MoseychukA/ASDB_INFO/README.md

# ASDB_INFO
Исходные файлы ADSB декодера
