MoseychukA/ASDB_INFO/adsbee-0.0.1/adsbee-0.0.1/excel/design_calculations.xlsx

Sheet: TLV3542 Noise Figure
Noise figure calculation paper: https://www.ti.com/lit/an/slyt094/slyt094.pdf
Parameter | Value | Units | Note

Sheet: AD8314 Input Match
Parameter | Value | Units | Note
Bandpass Filter
R_s | 52.3 | Ohms | Source impedance, from AD8314 datasheet (in parallel with AD8314 input, should yield 50 Ohms).
R_bp,L | 760 | Ohms | Resistance of AD8314 input at resonant frequency.
X_bp,L | -106 | j*Ohms | Reactance of AD8314 input at resonant frequency.
Z_bp_L | 767.3565012 | Ohms | Magnitude of bandpass filter load impedance (same as input impedance of AS8314 at bandpass filter resonant frequency).
f_r,bp,center | 1090 | MHz
w_r,bp,center | 6848.671985 | Mrad/s
Low Frequency
f_r,bp,lf | 1075 | MHz
w_r,bp,lf | 6754.424205 | Mrad/s
L_bp,lf | 6.8 | nH | Bandpass filter inductor value.
C_bp,lf | 3.223401637 | pF
C_bp,lf,bot | 20 | pF | Bottom capacitor value for tapped input of low frequency side of coupled resonator bandpass filter.
C_bp,lf_top | 3.842735657 | pF | Top capacitor value for tapped input of low frequency side of coupled resonator bandpass filter.
Coupling
R_bp,sp | 2013.41285 | Ohms | R_s' of coupled resonator equivalent circuit. Must be > Z_bp_L, preferably by a good amount.
X_bp,lf | -45.29801921 | j*Ohms | Reactance of bandpass filter low frequency resoinator's equivalent capacitor.
X_bp,lf,tot | -31.73597421 | j*Ohms
R_bp,lf,tot | 551.7367405 | Ohms
Q | 17.38521518 |  | Loaded Q of a single resonator in the bandpass filter. R is dominated by R_L. Q = X / R for reactance in prallel with resistance.
C_bp,coupling | 0.1854105114 | pF | Value of coupling capacitor connecting low frequency and high frequency resonators in bandpass filter.
L_bp,hf | 10 | nH
