MoseychukA/ASDB_INFO/adsbee-main/adsbee-main/firmware/ti/FreeRTOS-LTS/aws/aws-iot-core-mqtt-file-streams-embedded-c/docs/doxygen/images/MqttStreams_flowChart.jpg

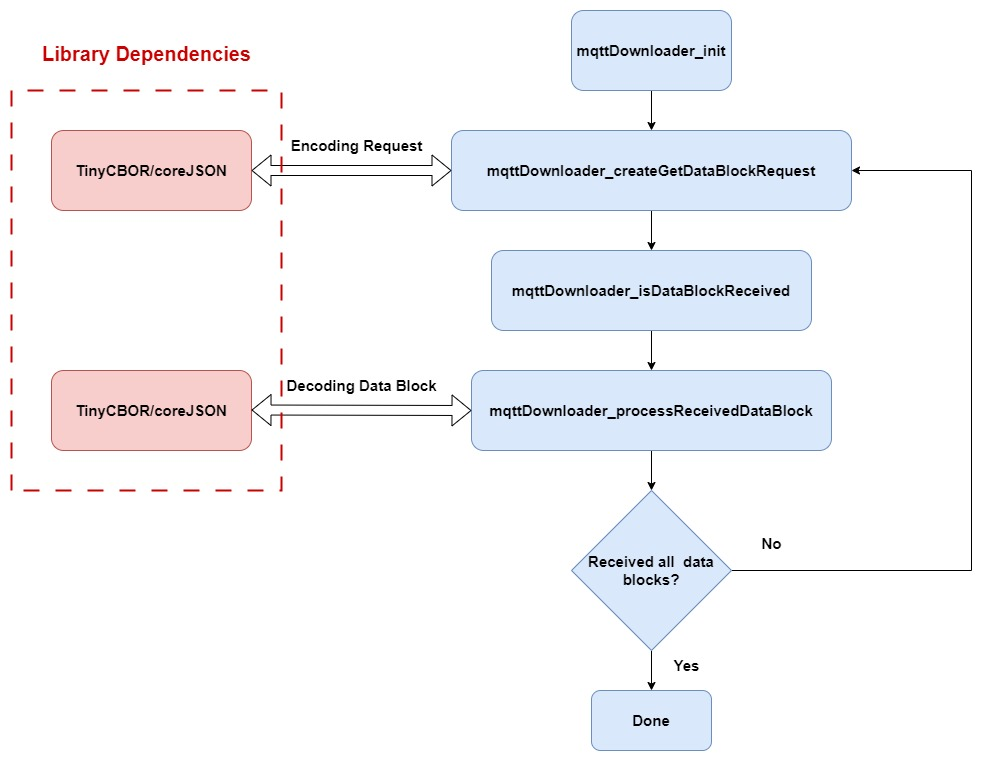
adsbee-main/adsbee-main/firmware/ti/FreeRTOS-LTS/aws/aws-iot-core-mqtt-file-streams-embedded-c/docs/doxygen/images/MqttStreams_flowChart.jpg
