MoseychukA/ASDB_INFO/adsbee-main/adsbee-main/firmware/ti/FreeRTOS-LTS/aws/sigv4-for-aws-iot-embedded-sdk/docs/plantuml/images/sigv4_design.png

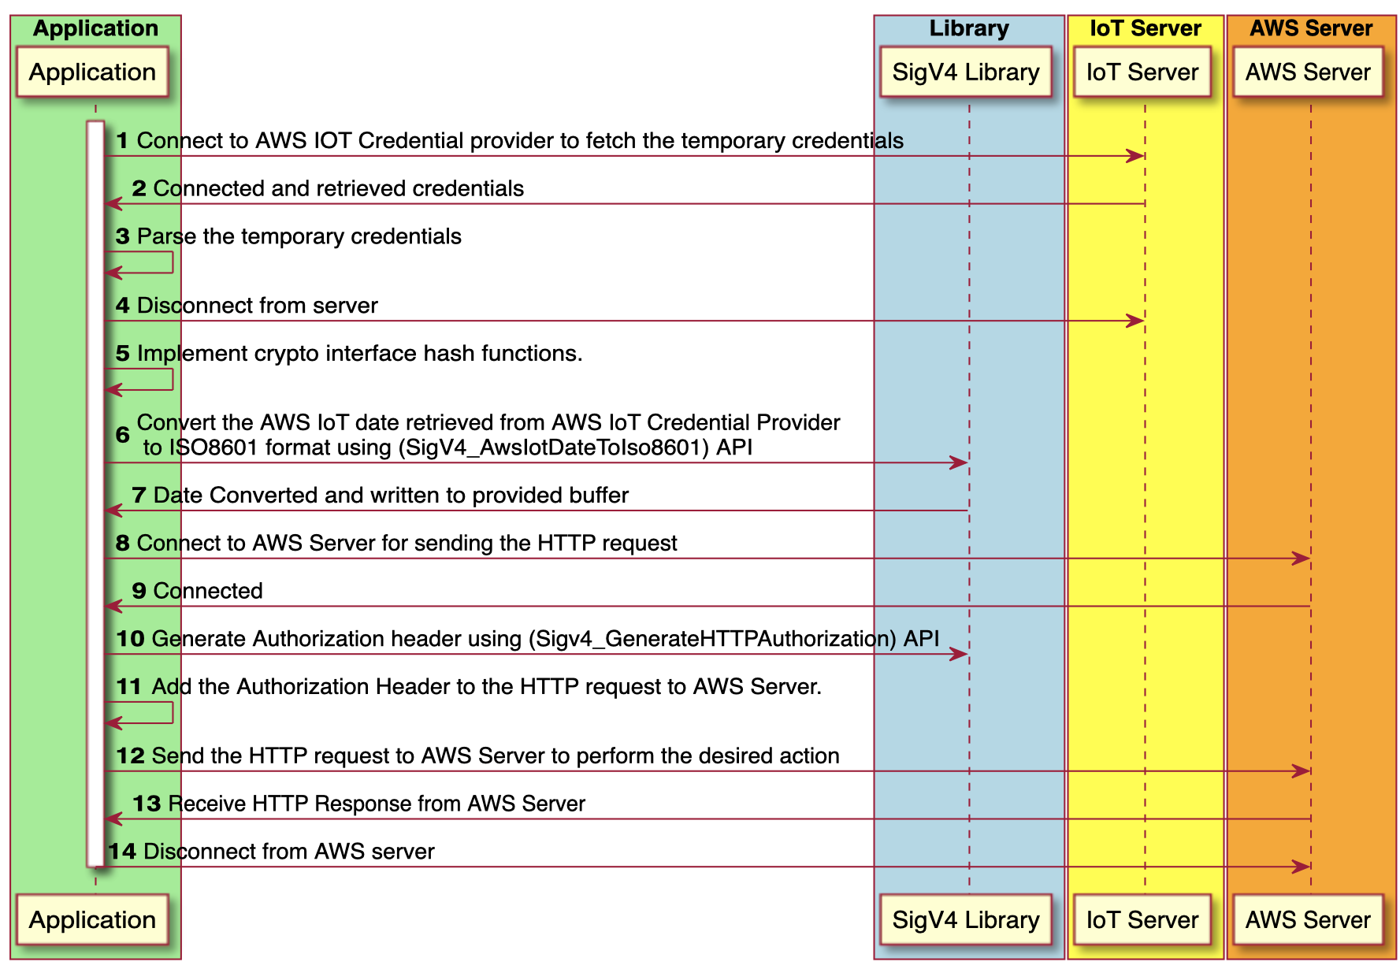
adsbee-main/adsbee-main/firmware/ti/FreeRTOS-LTS/aws/sigv4-for-aws-iot-embedded-sdk/docs/plantuml/images/sigv4_design.png
