MoseychukA/ASDB_INFO/DOC/2025-06-22_09-52-29.png

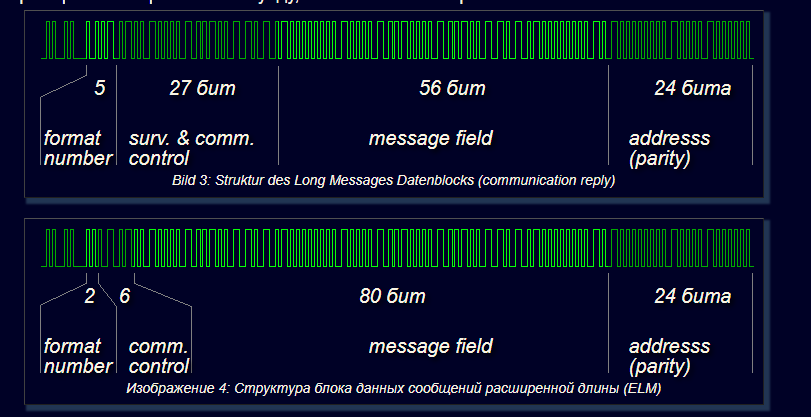
DOC/2025-06-22_09-52-29.png
