MoseychukA/ASDB_INFO/DOC/Pico1.webp

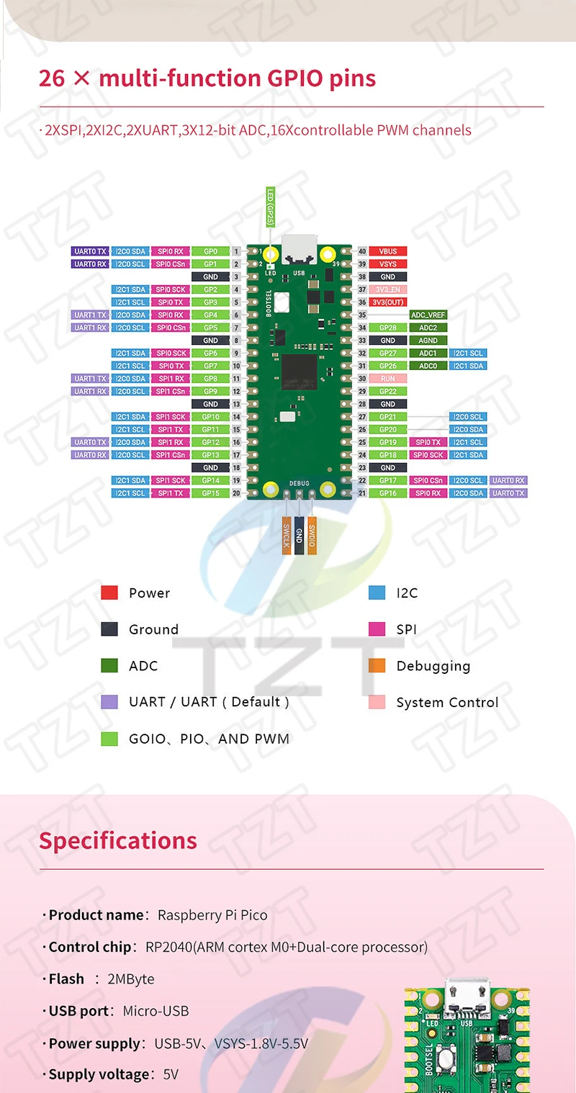
DOC/Pico1.webp
