MoseychukA/ASDB_INFO/DOC/Pico16.webp

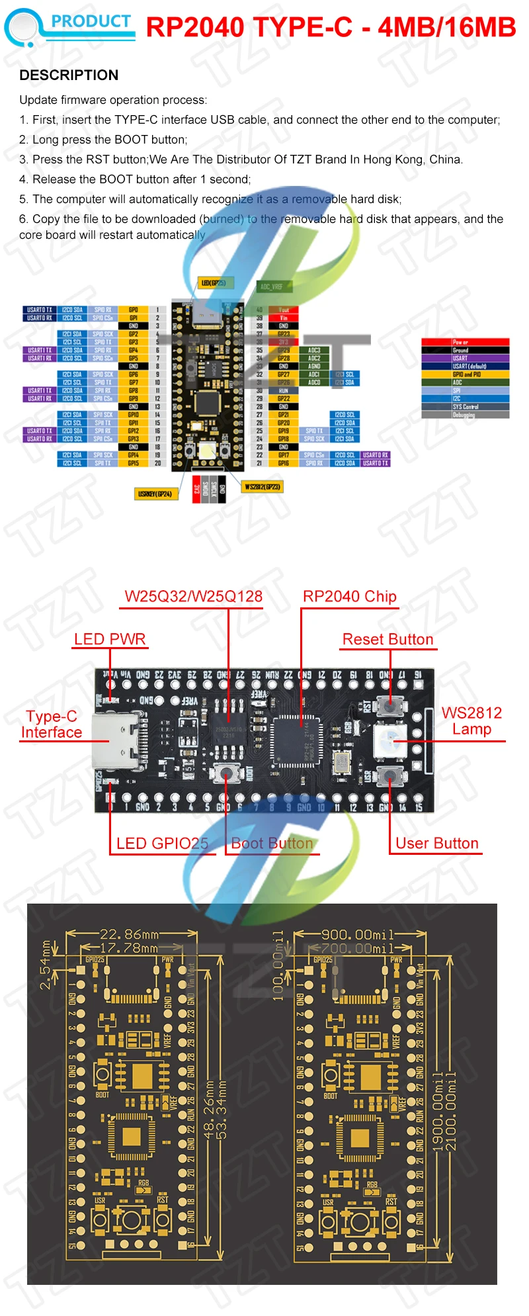
DOC/Pico16.webp
