MoseychukA/ASDB_INFO/Антенна 1090.png

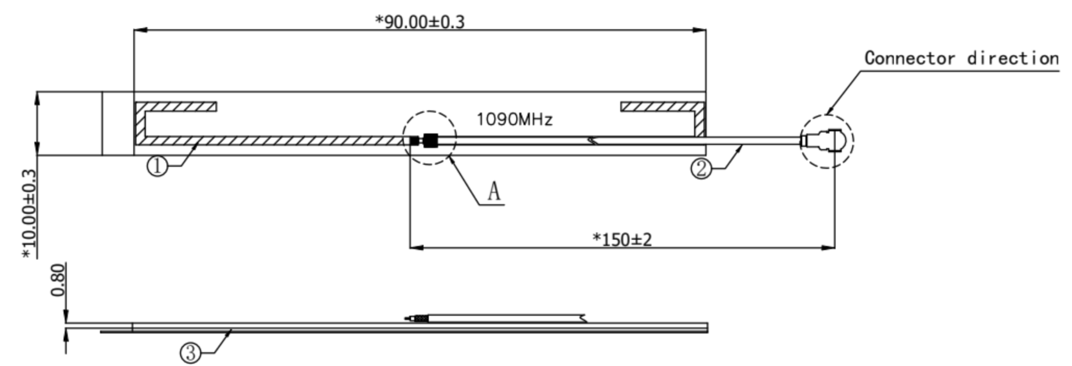
Антенна 1090.png
