MoseychukA/ASDB_INFO/adsbee-0.0.1/adsbee-0.0.1/affinity/promotional_materials/exports/adsbee_1090_qr.png

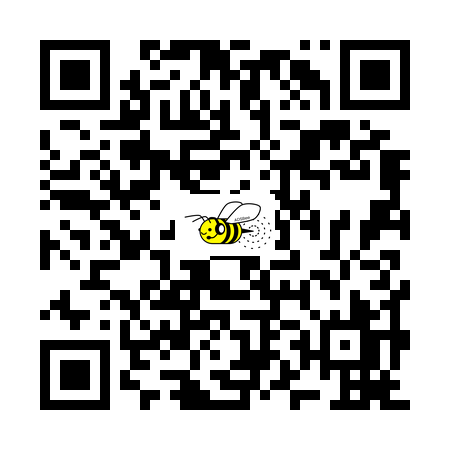
adsbee-0.0.1/adsbee-0.0.1/affinity/promotional_materials/exports/adsbee_1090_qr.png
