MoseychukA/ASDB_INFO/adsbee-adsbee_1090-0.8.0-rc3/adsbee-adsbee_1090-0.8.0-rc3/affinity/promotional_materials/exports/sticker_back_qr.png

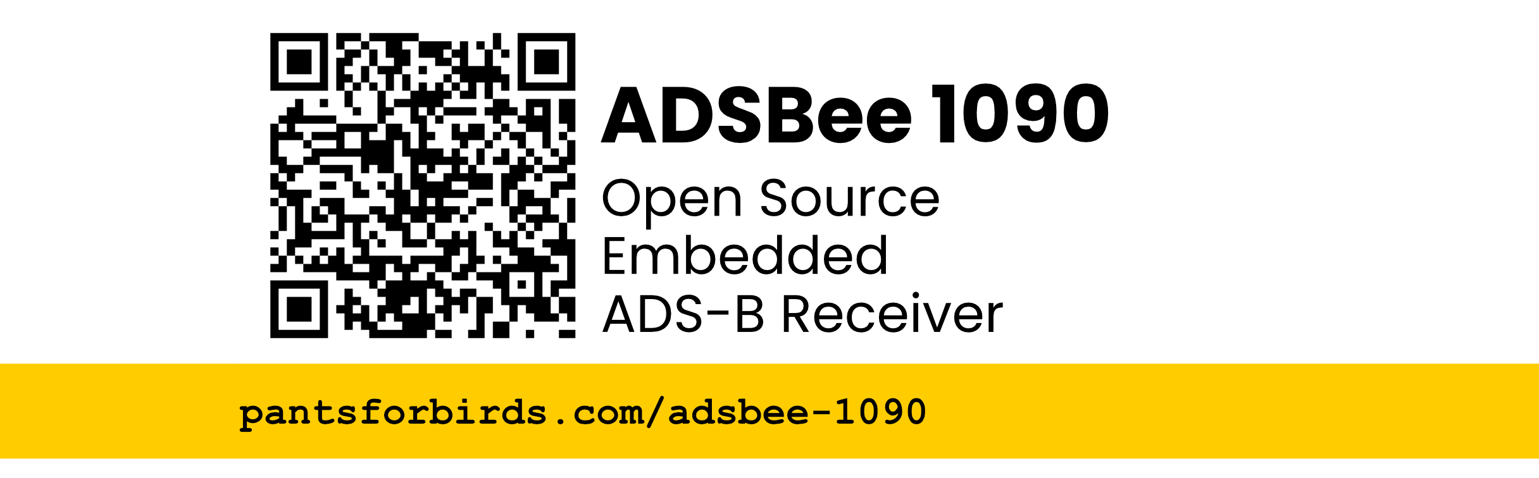
adsbee-adsbee_1090-0.8.0-rc3/adsbee-adsbee_1090-0.8.0-rc3/affinity/promotional_materials/exports/sticker_back_qr.png
