MoseychukA/ASDB_INFO/adsbee-0.0.1/adsbee-0.0.1/solidworks/proto_adsbee_1090_enclosure/fab/programming_plugs.STL

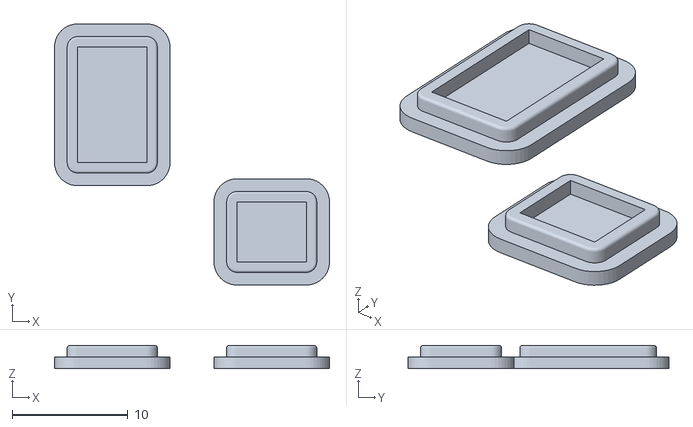
[picture p14: CAD file, 2025-06-20]
adsbee-0.0.1/adsbee-0.0.1/solidworks/proto_adsbee_1090_enclosure/fab/programming_plugs.STL
23.8 x 22.6 x 2.00
