MoseychukA/ASDB_INFO/adsbee-0.0.1/adsbee-0.0.1/solidworks/proto_adsbee_1090_solar_enclosure/adsbee_1090_solar_enclosure_backplane.SLDPRT

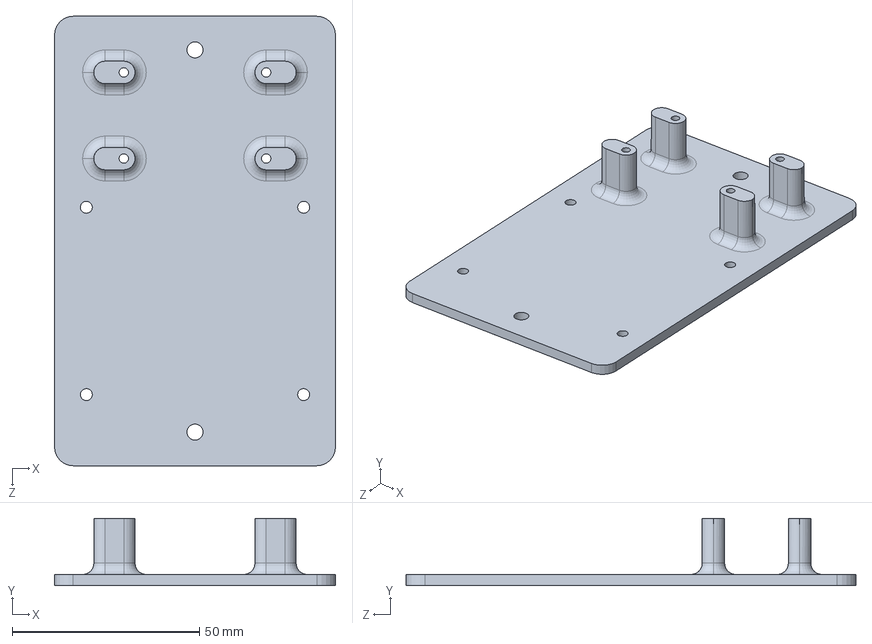
[picture p15: CAD file, 2025-06-20]
adsbee-0.0.1/adsbee-0.0.1/solidworks/proto_adsbee_1090_solar_enclosure/adsbee_1090_solar_enclosure_backplane.SLDPRT
75.0 x 18.0 x 120.0 mm
