MoseychukA/ASDB_INFO/adsbee-adsbee_1090-0.8.0-rc3/adsbee-adsbee_1090-0.8.0-rc3/3d/adsbee_1090_enclosure/Latch - B.stl

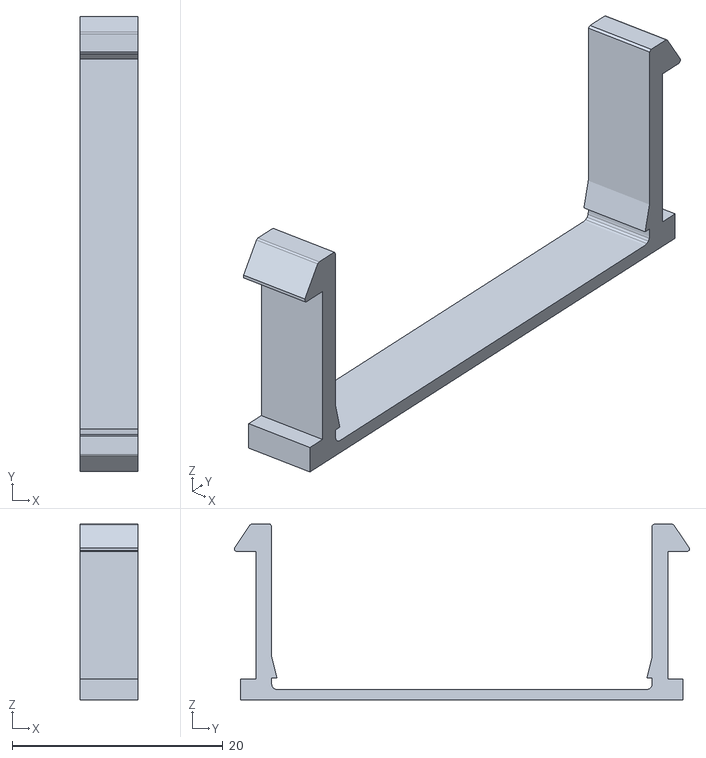
[picture p16: CAD file, 2025-06-20]
adsbee-adsbee_1090-0.8.0-rc3/adsbee-adsbee_1090-0.8.0-rc3/3d/adsbee_1090_enclosure/Latch - B.stl
5.50 x 43.2 x 16.7
