MoseychukA/ASDB_INFO/adsbee-adsbee_1090-0.8.0-rc3/adsbee-adsbee_1090-0.8.0-rc3/3d/adsbee_1090_indoor_feeder_enclosure/6x_indoor_feeder_enclosure_yellow_black.3mf

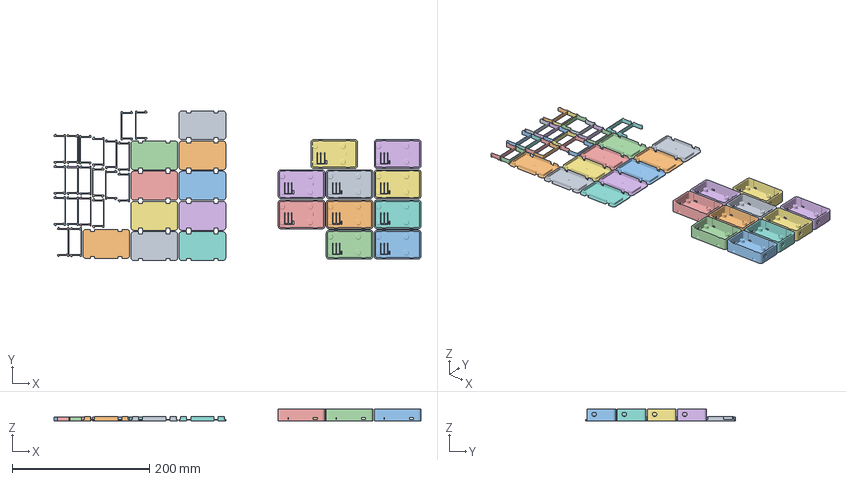
[picture p17: CAD file, 2025-06-20]
adsbee-adsbee_1090-0.8.0-rc3/adsbee-adsbee_1090-0.8.0-rc3/3d/adsbee_1090_indoor_feeder_enclosure/6x_indoor_feeder_enclosure_yellow_black.3mf
534.5 x 218.5 x 17.0 mm
Back Cover (Default) - B.stl x 10
Latch - B.stl x 20
Enclosure Front Cover - B.stl x 10
