MoseychukA/ASDB_INFO/adsbee-adsbee_1090-0.8.0-rc3/adsbee-adsbee_1090-0.8.0-rc3/3d/adsbee_1090_tall_enclosure/adsbee_1090_tall_enclosure_yellow_black.3mf

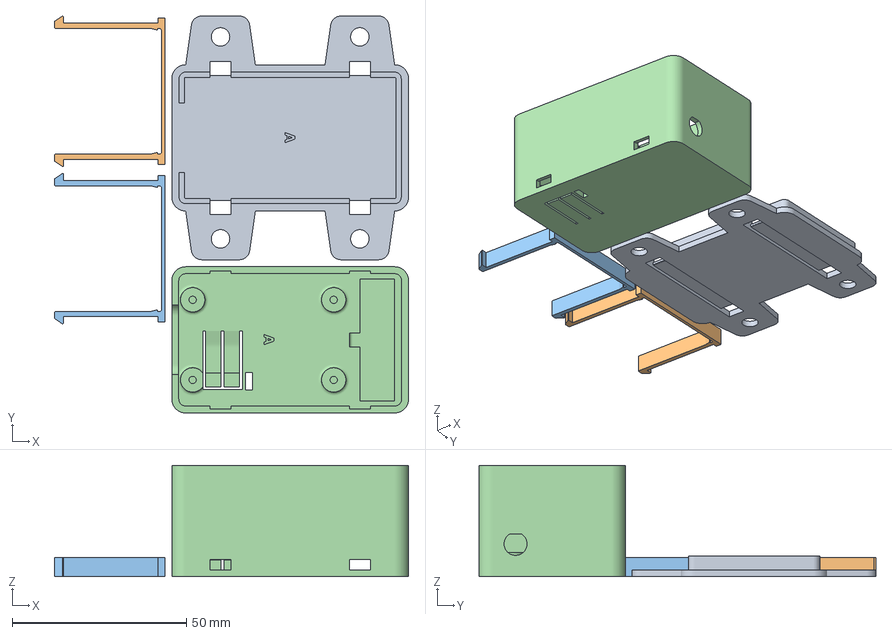
[picture p18: CAD file, 2025-06-20]
adsbee-adsbee_1090-0.8.0-rc3/adsbee-adsbee_1090-0.8.0-rc3/3d/adsbee_1090_tall_enclosure/adsbee_1090_tall_enclosure_yellow_black.3mf
101.7 x 114.0 x 32.0 mm
Back Cover.stl
Latch.stl x 2
Enclosure Front Cover.stl
