MoseychukA/ASDB_INFO/adsbee-adsbee_1090-0.8.0-rc3/adsbee-adsbee_1090-0.8.0-rc3/affinity/adsbee_logo/exports/adsbee_logo.dxf

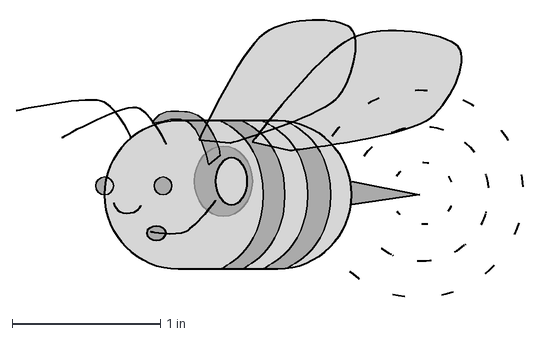
[picture p19: CAD file, 2025-06-20]
adsbee-adsbee_1090-0.8.0-rc3/adsbee-adsbee_1090-0.8.0-rc3/affinity/adsbee_logo/exports/adsbee_logo.dxf
3.42 x 1.90 in
