MoseychukA/ASDB_INFO/adsbee-main/adsbee-main/3d/adsbee_1090_tall_enclosure/Latch.stl

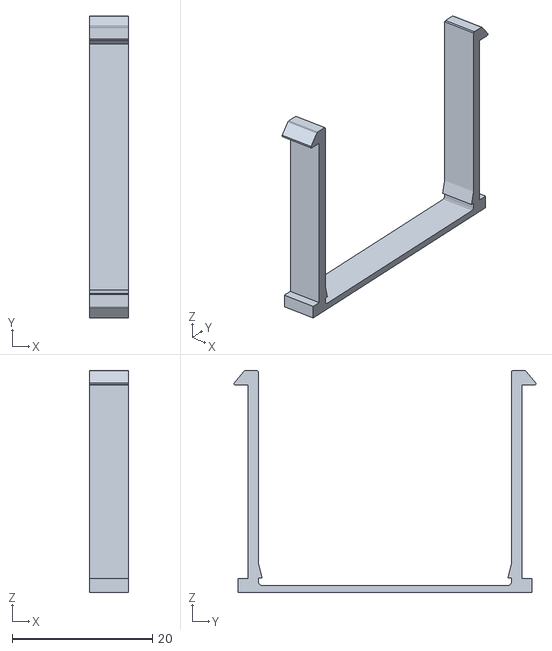
[picture p20: CAD file, 2025-06-20]
adsbee-main/adsbee-main/3d/adsbee_1090_tall_enclosure/Latch.stl
5.50 x 43.1 x 31.7
