MoseychukA/ASDB_INFO/adsbee-main/adsbee-main/affinity/adsbee_logo/exports/adsbee_logo_bw_outline.dxf

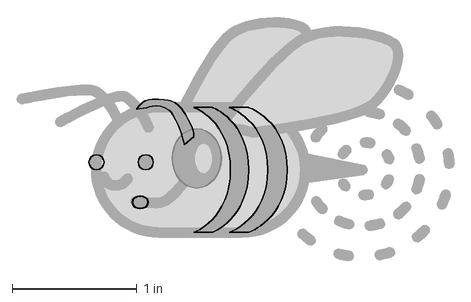
[picture p21: CAD file, 2025-06-20]
adsbee-main/adsbee-main/affinity/adsbee_logo/exports/adsbee_logo_bw_outline.dxf
3.51 x 1.96 in
