MoseychukA/ASDB_INFO/adsbee-0.0.1/adsbee-0.0.1/solidworks/proto_adsbee_1090_enclosure/fab/top_cover.STL

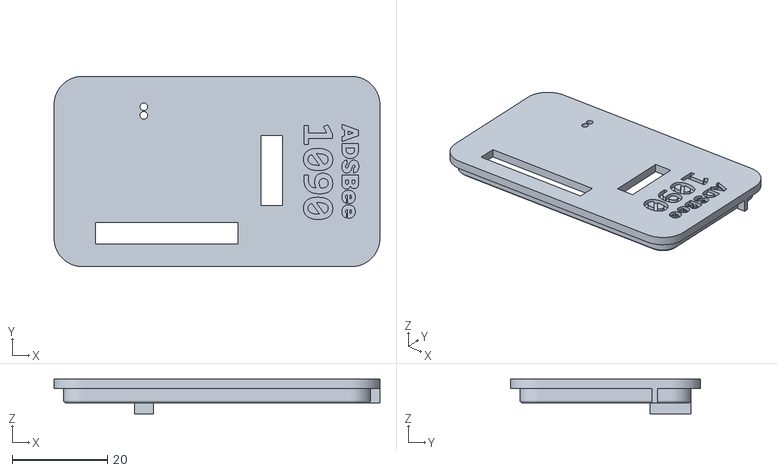
[picture p22: CAD file, 2025-06-20]
adsbee-0.0.1/adsbee-0.0.1/solidworks/proto_adsbee_1090_enclosure/fab/top_cover.STL
68.5 x 40.0 x 7.27
