MoseychukA/ASDB_INFO/adsbee-main/adsbee-main/3d/adsbee_1090_enclosure/indoor_feeder_enclosure_gray.3mf

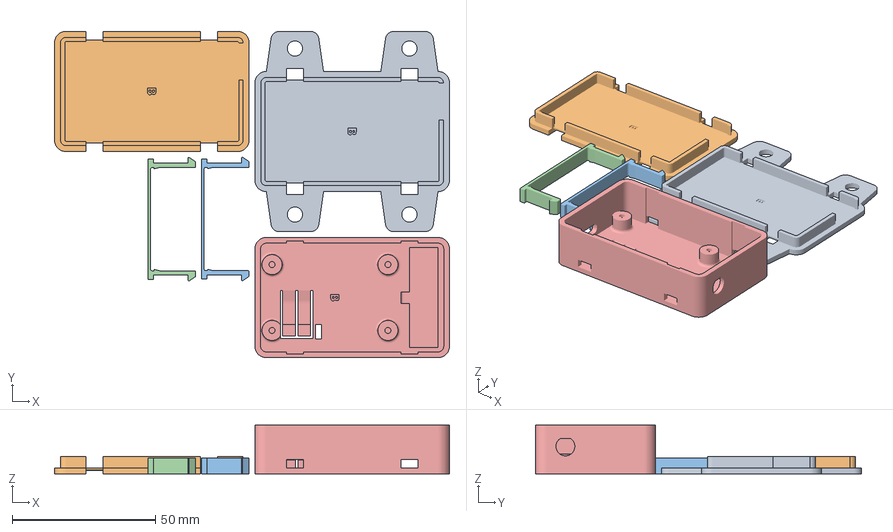
[picture p24: CAD file, 2025-06-20]
adsbee-main/adsbee-main/3d/adsbee_1090_enclosure/indoor_feeder_enclosure_gray.3mf
138.0 x 114.0 x 17.0 mm
Back Cover (Bracket) - B.stl
Back Cover (Default) - B.stl
Latch - B.stl x 2
Enclosure Front Cover - B.stl
