MoseychukA/ASDB_INFO/adsbee-0.0.1/adsbee-0.0.1/solidworks/proto_adsbee_1090_enclosure/fab/side_walls.STL

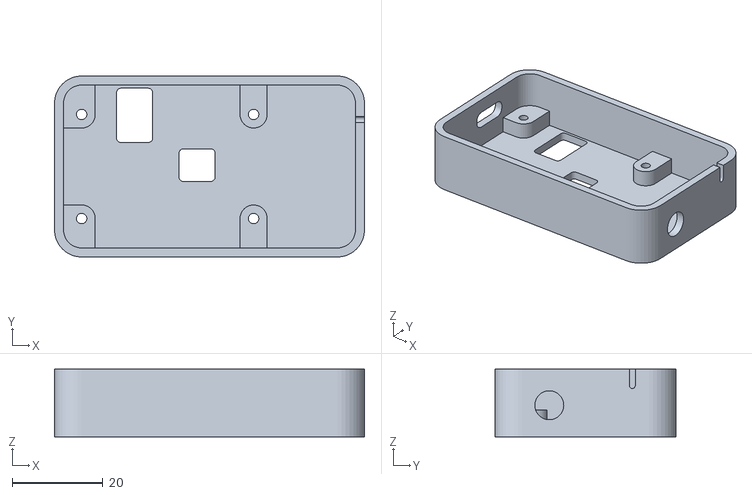
[picture p26: CAD file, 2025-06-20]
adsbee-0.0.1/adsbee-0.0.1/solidworks/proto_adsbee_1090_enclosure/fab/side_walls.STL
68.5 x 40.0 x 15.0
