MoseychukA/ASDB_INFO/adsbee-adsbee_1090-0.8.0-rc3/adsbee-adsbee_1090-0.8.0-rc3/3d/adsbee_1090_enclosure/Enclosure Front Cover - B.stl

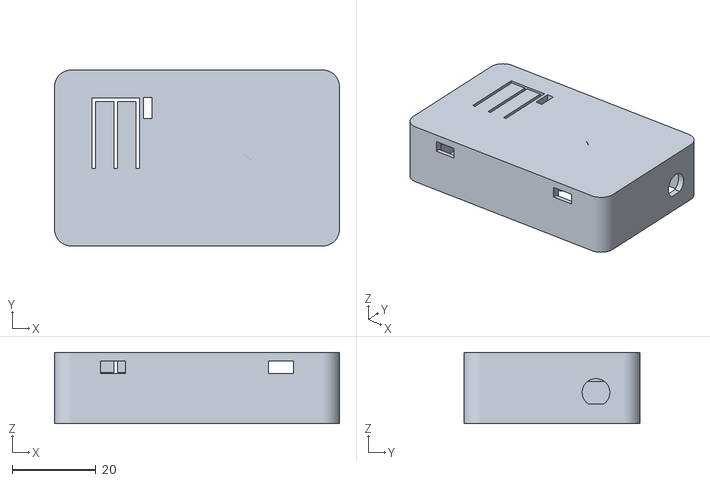
[picture p27: CAD file, 2025-06-20]
adsbee-adsbee_1090-0.8.0-rc3/adsbee-adsbee_1090-0.8.0-rc3/3d/adsbee_1090_enclosure/Enclosure Front Cover - B.stl
68.0 x 42.0 x 17.0
