MoseychukA/ASDB_INFO/adsbee-main/adsbee-main/3d/adsbee_1090_enclosure/Back Cover (Bracket) - B.stl

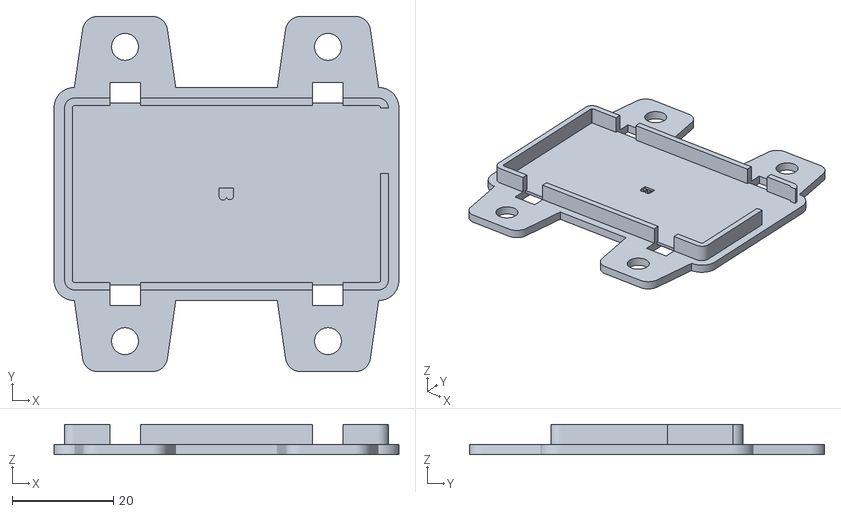
[picture p28: CAD file, 2025-06-20]
adsbee-main/adsbee-main/3d/adsbee_1090_enclosure/Back Cover (Bracket) - B.stl
68.0 x 70.0 x 6.00
