MoseychukA/ASDB_INFO/adsbee-main/adsbee-main/3d/adsbee_1090_tall_enclosure/Enclosure Front Cover.stl

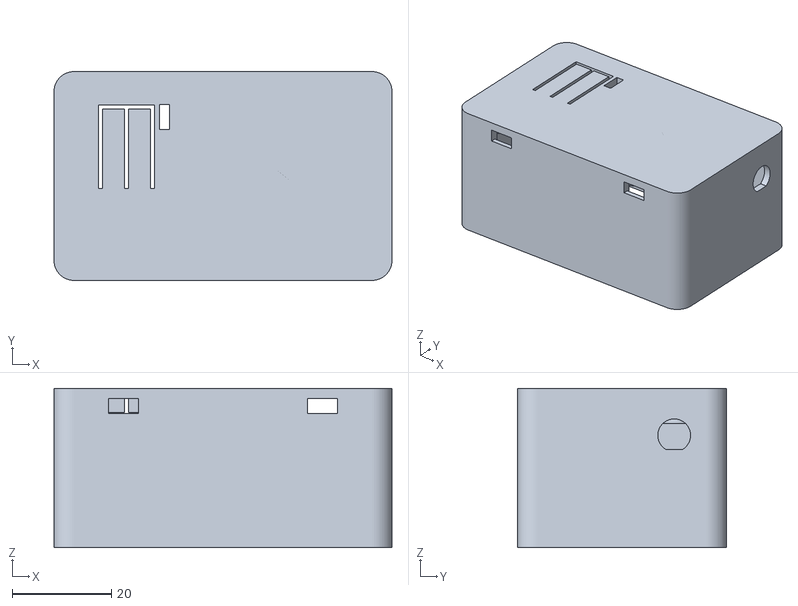
[picture p29: CAD file, 2025-06-20]
adsbee-main/adsbee-main/3d/adsbee_1090_tall_enclosure/Enclosure Front Cover.stl
68.0 x 42.0 x 32.0
