MoseychukA/ASDB_INFO/adsbee-main/adsbee-main/3d/adsbee_1090_enclosure/6x_indoor_feeder_enclosure_gray.3mf

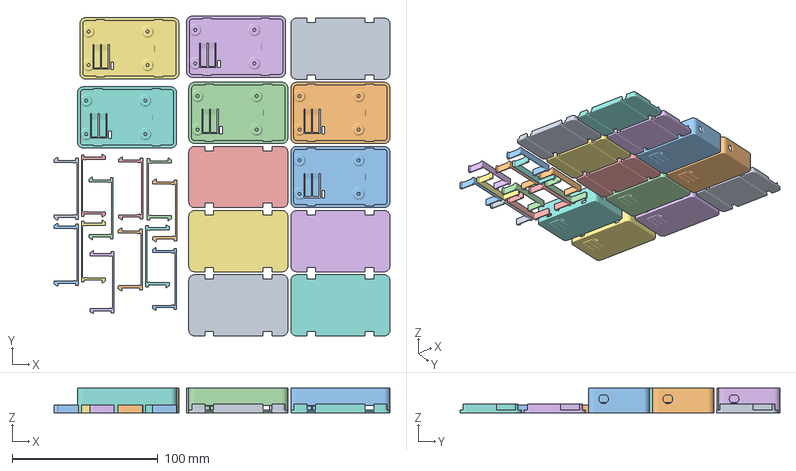
[picture p30: CAD file, 2025-06-20]
adsbee-main/adsbee-main/3d/adsbee_1090_enclosure/6x_indoor_feeder_enclosure_gray.3mf
230.4 x 219.4 x 17.0 mm
Back Cover (Default) - B.stl x 6
Enclosure Front Cover - B.stl x 6
Latch - B.stl x 12
