MoseychukA/ASDB_INFO/(list of files, cad)

Other CAD files:
adsbee-0.0.1/adsbee-0.0.1/solidworks/proto_adsbee_1090_solar_enclosure/fab/adsbee_1090_solar_enclosure_backplane.STL
adsbee-main/adsbee-main/3d/adsbee_1090_enclosure/indoor_feeder_enclosure.3mf.3mf
adsbee-adsbee_1090-0.8.0-rc3/adsbee-adsbee_1090-0.8.0-rc3/3d/adsbee_1090_enclosure/indoor_feeder_enclosure.3mf.3mf
adsbee-main/adsbee-main/3d/adsbee_1090_enclosure/10x_indoor_feeder_enclosure_yellow_black.3mf
adsbee-adsbee_1090-0.8.0-rc3/adsbee-adsbee_1090-0.8.0-rc3/3d/adsbee_1090_enclosure/10x_indoor_feeder_enclosure_yellow_black.3mf
