MoseychukA/ASDB_INFO/adsbee-adsbee_1090-0.8.0-rc3/adsbee-adsbee_1090-0.8.0-rc3/affinity/adsbee_1090_wiring_diagrams/exports/adsbee_1090_w5500_lite.png

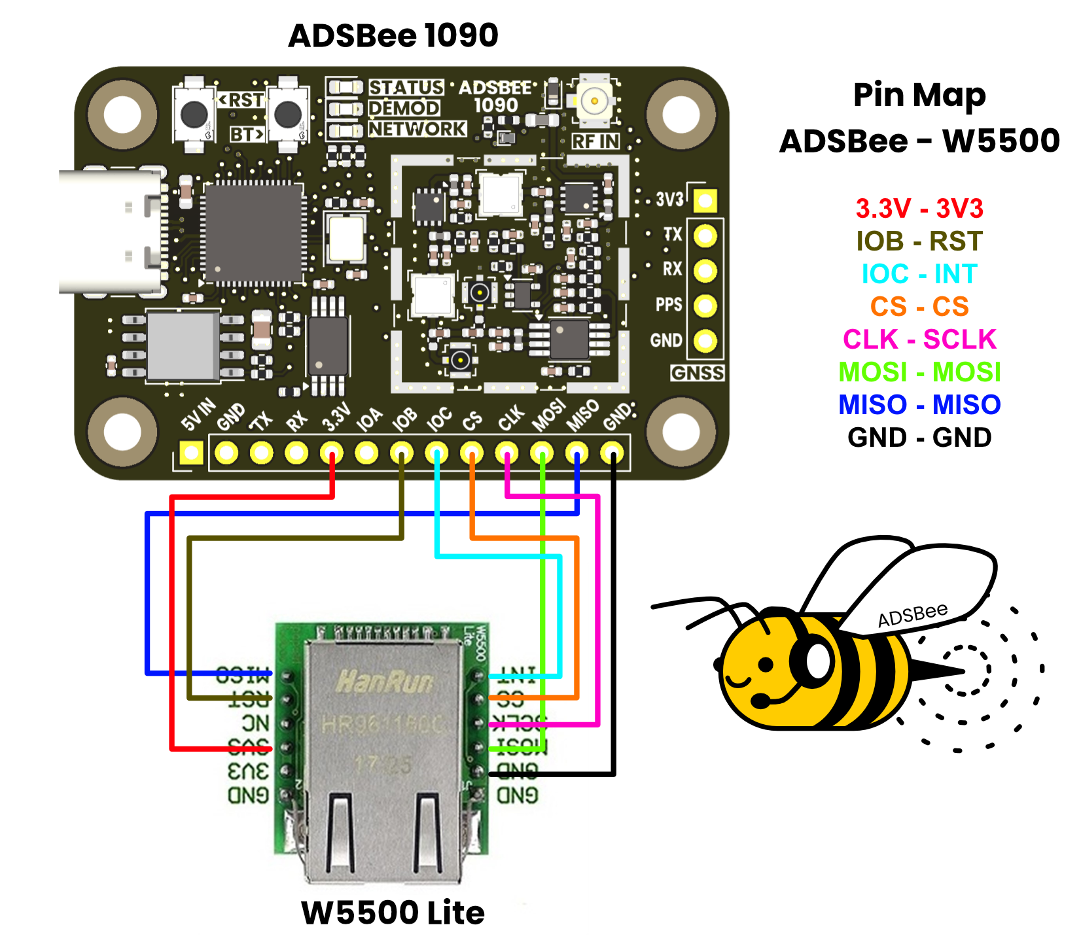
adsbee-adsbee_1090-0.8.0-rc3/adsbee-adsbee_1090-0.8.0-rc3/affinity/adsbee_1090_wiring_diagrams/exports/adsbee_1090_w5500_lite.png
