MoseychukA/ASDB_INFO/adsbee-main/adsbee-main/firmware/ti/FreeRTOS-LTS/aws/device-defender-for-aws-iot-embedded-sdk/docs/plantuml/images/defender_design_operations.png

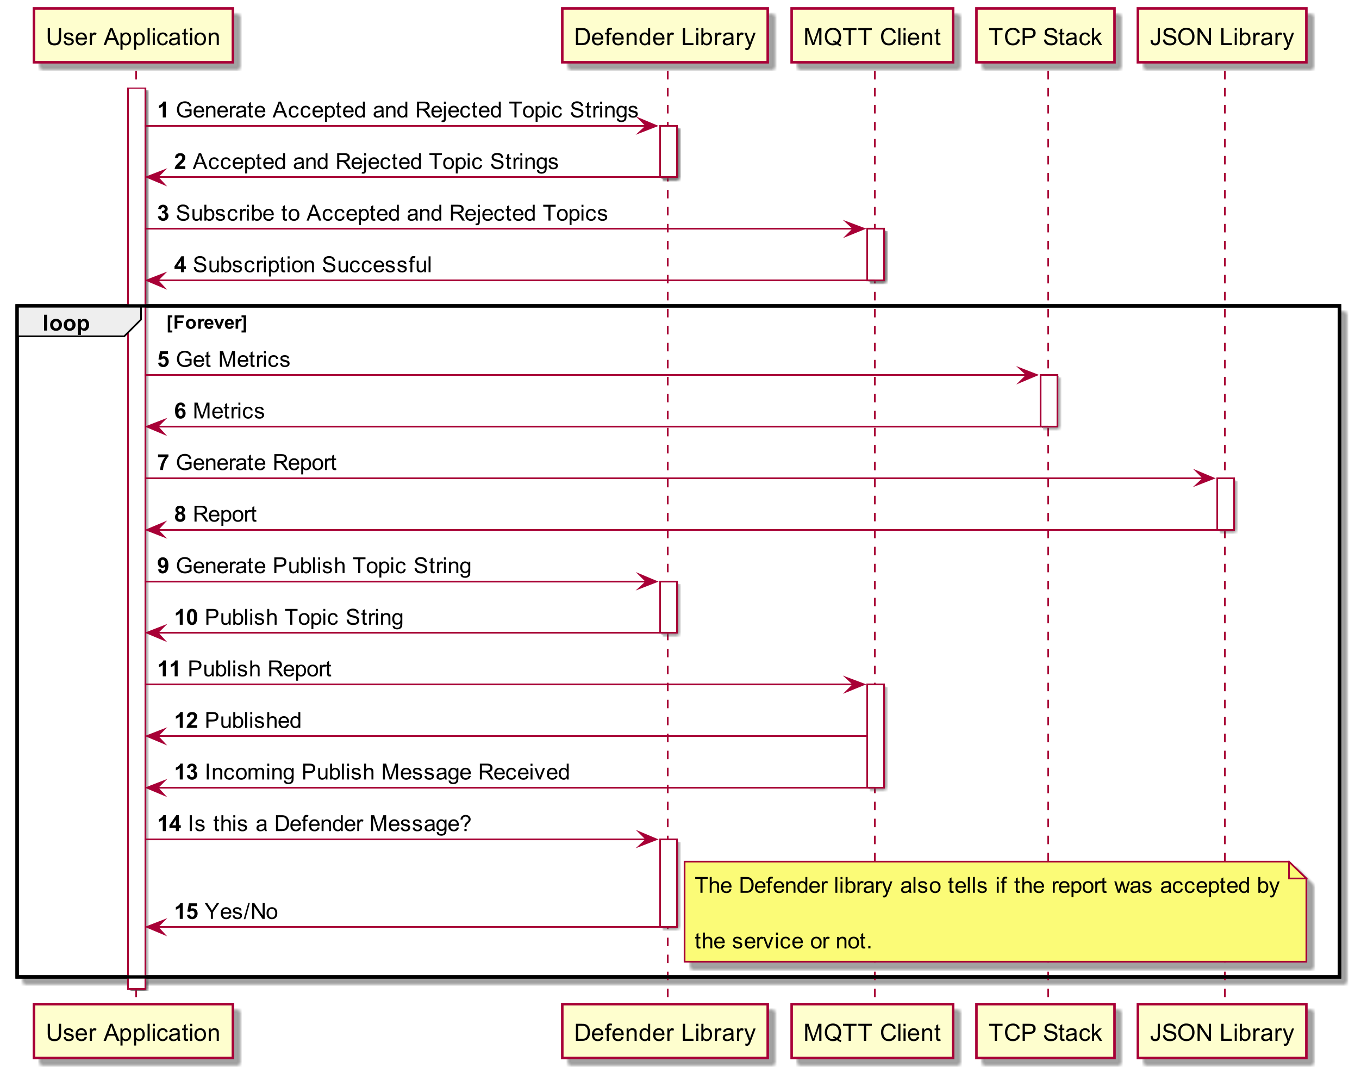
adsbee-main/adsbee-main/firmware/ti/FreeRTOS-LTS/aws/device-defender-for-aws-iot-embedded-sdk/docs/plantuml/images/defender_design_operations.png
