MoseychukA/ASDB_INFO/adsbee-main/adsbee-main/firmware/ti/FreeRTOS-LTS/aws/device-shadow-for-aws-iot-embedded-sdk/docs/plantuml/images/shadow_design_operation.png

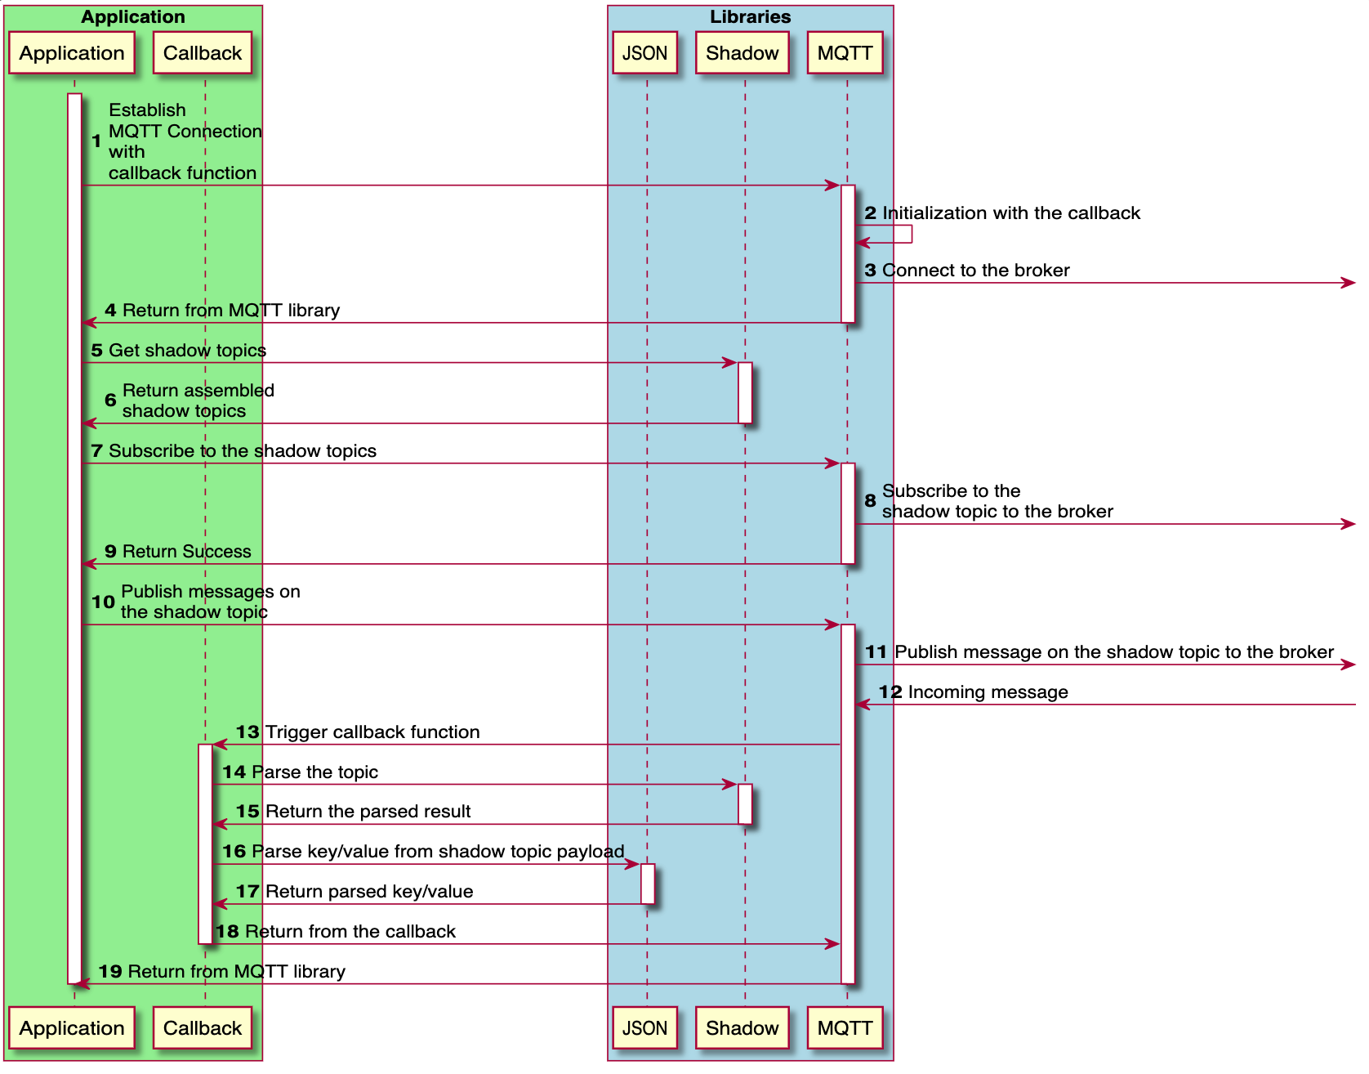
adsbee-main/adsbee-main/firmware/ti/FreeRTOS-LTS/aws/device-shadow-for-aws-iot-embedded-sdk/docs/plantuml/images/shadow_design_operation.png
