MoseychukA/ASDB_INFO/adsbee-main/adsbee-main/firmware/ti/FreeRTOS-LTS/aws/fleet-provisioning-for-aws-iot-embedded-sdk/docs/plantuml/images/fleet_provisioning_operations.png

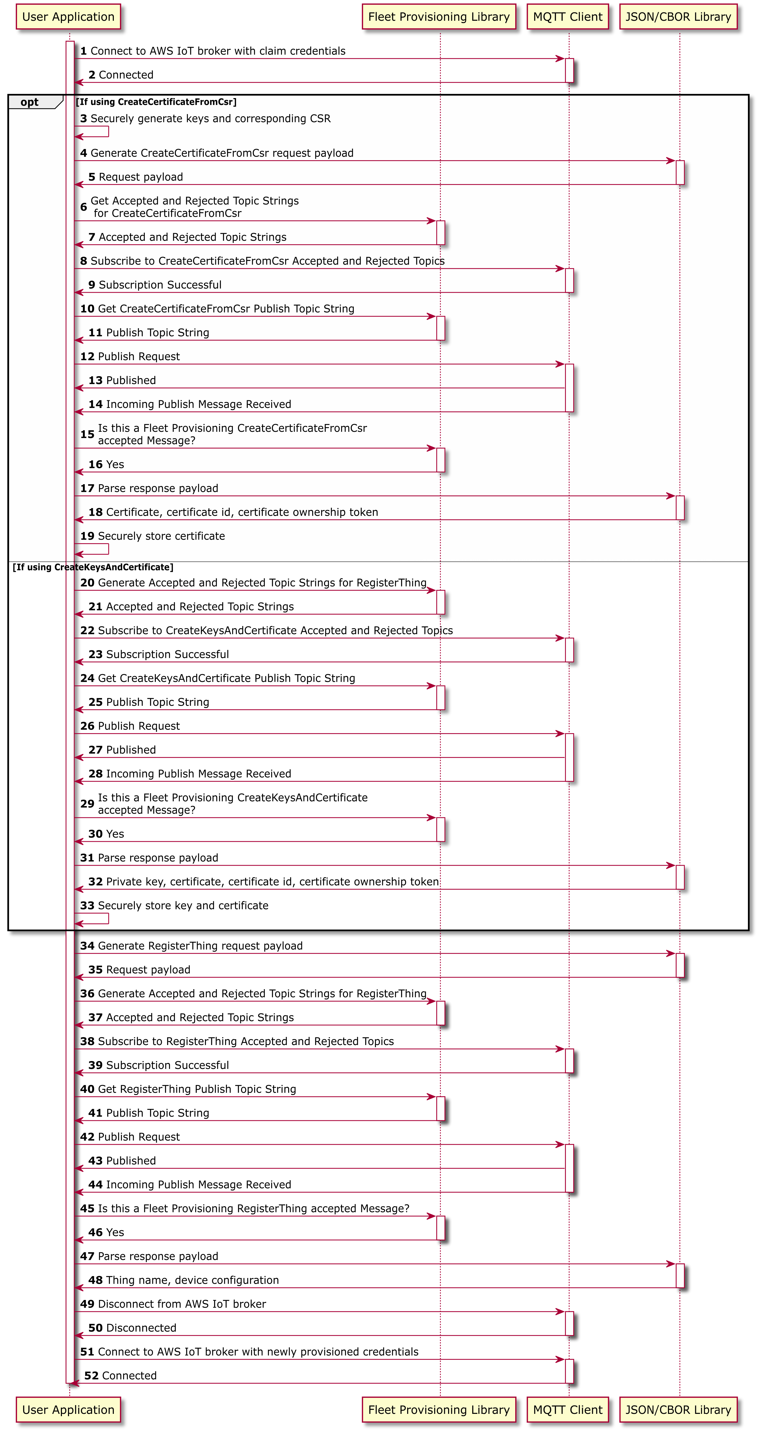
adsbee-main/adsbee-main/firmware/ti/FreeRTOS-LTS/aws/fleet-provisioning-for-aws-iot-embedded-sdk/docs/plantuml/images/fleet_provisioning_operations.png
