MoseychukA/ASDB_INFO/adsbee-0.0.1/adsbee-0.0.1/excel/mtl_calibration.xlsx

mtl_bias_pwm_count | mtl_bias_adc_count | comp_bias_dc [mV] | Expected comp_bias_dc [mV] | Error comp_bias_dc [mV] | Corrected mtl_bias_pwm_count
0 | 11 | 0 | 0 | 0 | -16.0676799
500 | 287 | 222 | 330 | -108 | 520.1145358
1000 | 575 | 436 | 660 | -224 | 1004.860713
1500 | 860 | 670 | 990 | -320 | 1502.25097
2000 | 1170 | 919 | 1320 | -401 | 1998.142142
2500 | 1518 | 1183 | 1650 | -467 | 2491.24367
3000 | 1850 | 1461 | 1980 | -519 | 2979.96332
3500 | 2222 | 1784 | 2310 | -526 | 3516.640025
4000 | 2594 | 2092 | 2640 | -548 | 4005.814047
4500 | 2985 | 2413 | 2970 | -557 | 4501.543688
5000 | 3393 | 2736 | 3300 | -564 | 4995.49457
mtl_bias_pwm_count Polynomial | COEFF_X^3 | COEFF_X^2 | COEFF_X | COEFF_CONST
 | 4.872987039e-08 | -0.0003762526851 | 2.496361699 | -16.0676799
