MoseychukA/ASDB_INFO/adsbee-adsbee_1090-0.8.0-rc3/adsbee-adsbee_1090-0.8.0-rc3/firmware/common/adsb/nasa_cpr/airborne/benchmarks/encoding/MOPS-table-2-139.csv

0 | C0000000 | 80000000 | 00000 | 10000
1 | C0000000 | 80000000 | 08000 | 10000
0 | C0091A2B | 7FA4FA50 | 00444 | 0FF4A
1 | C0091A2B | 7FA4FA50 | 08432 | 0FF4A
0 | C05B05B0 | 7EEEEEEF | 02AAB | 0FDDE
1 | C05B05B0 | 7EEEEEEF | 0A9F5 | 0FDDE
0 | C0B60B61 | 7CCCCCCD | 05555 | 0F99A
1 | C0B60B61 | 7CCCCCCD | 0D3E9 | 0F99A
0 | C1C71C72 | 8AAAAAAB | 0D555 | 11555
1 | C1C71C72 | 8AAAAAAB | 151C7 | 11555
0 | C24FA4FA | 860B60B6 | 11555 | 0182E
1 | C24FA4FA | 860B60B6 | 190B6 | 10C17
0 | C27D27D2 | 85555555 | 12AAB | 12000
1 | C27D27D2 | 85555555 | 1A5B0 | 01555
0 | C2F37C05 | 2EC16C17 | 16222 | 11889
1 | C2F37C05 | 2EC16C17 | 1DC3B | 0BB06
0 | C38E38E4 | 9A7D27D2 | 1AAAB | 0D3E9
1 | C38E38E4 | 9A7D27D2 | 0238E | 19EEF
0 | C416C16C | 2AAAAAAB | 1EAAB | 1AAAB
1 | C416C16C | 2AAAAAAB | 0627D | 15555
0 | C4962FC9 | D5555555 | 02666 | 00000
1 | C4962FC9 | D5555555 | 09D3A | 05555
0 | C53490BA | 55555555 | 070A4 | 0AAAB
1 | C53490BA | 55555555 | 0E63B | 00000
0 | C5DDDDDE | AAAAAAAB | 0C000 | 0AAAB
1 | C5DDDDDE | AAAAAAAB | 13444 | 15555
0 | C6EEEEEF | 66666666 | 14000 | 13333
1 | C6EEEEEF | 66666666 | 1B222 | 06666
0 | C749F49F | 9999999A | 16AAB | 00000
1 | C749F49F | 9999999A | 1DC17 | 0CCCD
0 | C83FB72F | A9F49F4A | 1DDDE | 09B06
1 | C83FB72F | A9F49F4A | 04D5E | 1471C
0 | C8F5C28F | 560B60B6 | 03333 | 01111
1 | C8F5C28F | 560B60B6 | 0A148 | 164FA
0 | C9907F6E | 924A2EE0 | 07BBC | 0DB89
1 | C9907F6E | 924A2EE0 | 0E89B | 1B6F4
0 | CA3D70A4 | 6DB5D120 | 0CCCD | 1FFE3
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
1 | 03A06D3A | 0471C71C | 1ABF2 | 0038E
0 | 01C71C72 | 6DB5D120 | 0D555 | 091CE
1 | 01C71C72 | 6DB5D120 | 0D1C7 | 1B663
0 | 00000000 | 2AAAAAAB | 00000 | 1AAAB
1 | 00000000 | 2AAAAAAB | 00000 | 15555
0 | 00000000 | 90000000 | 00000 | 06000
1 | 00000000 | 90000000 | 00000 | 14000
