MoseychukA/ASDB_INFO/adsbee-adsbee_1090-0.8.0-rc3/adsbee-adsbee_1090-0.8.0-rc3/firmware/common/adsb/nasa_cpr/airborne/benchmarks/encoding/t6-3awb.csv

0 | 3DDDDEEE | 80000000 | 10000 | 0
0 | 3DDDDEEF | 80000000 | 10001 | 10000
0 | 3D894999 | 80000000 | D85A | 10000
0 | 3D89499A | 80000000 | D85B | 0
0 | 3CFB4BBB | 80000000 | 95CB | 0
0 | 3CFB4BBC | 80000000 | 95CC | 10000
0 | 3C5E0DDD | 80000000 | 4C16 | 10000
0 | 3C5E0DDE | 80000000 | 4C17 | 0
0 | 3BBA3AAA | 80000000 | 1FF4B | 0
0 | 3BBA3AAB | 80000000 | 1FF4C | 10000
0 | 3B12CBBB | 80000000 | 1B0CF | 10000
0 | 3B12CBBC | 80000000 | 1B0D0 | 0
0 | 3A690DDD | 80000000 | 1613E | 0
0 | 3A690DDE | 80000000 | 1613F | 10000
0 | 39BDA555 | 80000000 | 110E5 | 10000
0 | 39BDA556 | 80000000 | 110E6 | 0
0 | 3910EDDD | 80000000 | BFEF | 0
0 | 3910EDDE | 80000000 | BFF0 | 10000
0 | 38631666 | 80000000 | 6E72 | 10000
0 | 38631667 | 80000000 | 6E73 | 0
0 | 37B43888 | 80000000 | 1C7A | 0
0 | 37B43889 | 80000000 | 1C7B | 10000
0 | 37046555 | 80000000 | 1CA0F | 10000
0 | 37046556 | 80000000 | 1CA10 | 0
0 | 36539EEE | 80000000 | 17732 | 0
0 | 36539EEF | 80000000 | 17733 | 10000
0 | 35A1E555 | 80000000 | 123E3 | 10000
0 | 35A1E556 | 80000000 | 123E4 | 0
0 | 34EF3222 | 80000000 | D01F | 0
0 | 34EF3223 | 80000000 | D020 | 10000
0 | 343B7CCC | 80000000 | 7BE2 | 10000
0 | 343B7CCD | 80000000 | 7BE3 | 0
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
