MoseychukA/ASDB_INFO/adsbee-adsbee_1090-0.8.0-rc3/adsbee-adsbee_1090-0.8.0-rc3/firmware/common/adsb/nasa_cpr/airborne/benchmarks/encoding/t6-4awb.csv

1 | 3DDDDE5F | 80000000 | 8444 | 10000
1 | 3DDDDE60 | 80000000 | 8445 | 10000
1 | 3D8948AD | 80000000 | 5D47 | 0
1 | 3D8948AE | 80000000 | 5D48 | 10000
1 | 3CFB4D04 | 80000000 | 1BD5 | 10000
1 | 3CFB4D05 | 80000000 | 1BD6 | 0
1 | 3C5E0E1A | 80000000 | 1D35A | 0
1 | 3C5E0E1B | 80000000 | 1D35B | 10000
1 | 3BBA3BA9 | 80000000 | 187D7 | 10000
1 | 3BBA3BAA | 80000000 | 187D8 | 0
1 | 3B12CAD8 | 80000000 | 13AA9 | 0
1 | 3B12CAD9 | 80000000 | 13AAA | 10000
1 | 3A690E1A | 80000000 | EC6C | 10000
1 | 3A690E1B | 80000000 | EC6D | 0
1 | 39BDA5F7 | 80000000 | 9D6A | 0
1 | 39BDA5F8 | 80000000 | 9D6B | 10000
1 | 3910ED8F | 80000000 | 4DCD | 10000
1 | 3910ED90 | 80000000 | 4DCE | 0
1 | 3863149C | 80000000 | 1FDAB | 0
1 | 3863149D | 80000000 | 1FDAC | 10000
1 | 37B4397D | 80000000 | 1AD12 | 10000
1 | 37B4397E | 80000000 | 1AD13 | 0
1 | 370464E1 | 80000000 | 15C06 | 0
1 | 370464E2 | 80000000 | 15C07 | 10000
1 | 36539F75 | 80000000 | 10A8B | 10000
1 | 36539F76 | 80000000 | 10A8C | 0
1 | 35A1E4E1 | 80000000 | B89F | 0
1 | 35A1E4E2 | 80000000 | B8A0 | 10000
1 | 34EF30D0 | 80000000 | 6640 | 10000
1 | 34EF30D1 | 80000000 | 6641 | 0
1 | 343B7CBE | 80000000 | 136B | 0
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
