MoseychukA/ASDB_INFO/adsbee-adsbee_1090-0.8.0-rc3/adsbee-adsbee_1090-0.8.0-rc3/firmware/common/adsb/nasa_cpr/airborne/benchmarks/global-decoding/airborne_globally_decoded_positions_01.csv

3DDDDEEE | 80000000 | 10000 | 0 | 3DDDDE5F | 80000000 | 8444 | 10000 | 1 | 3DDDDDDE | 80000000 | 3DDDDD4A | 80000000
3DDDDEEF | 80000000 | 10001 | 10000 | 3DDDDE60 | 80000000 | 8445 | 10000 | 1 | 3DDDE000 | 80000000 | 3DDDDF75 | 80000000
3D894999 | 80000000 | D85A | 10000 | 3D8948AD | 80000000 | 5D47 | 0 | 1 | 3D894889 | 80000000 | 3D894798 | 80000000
3D89499A | 80000000 | D85B | 0 | 3D8948AE | 80000000 | 5D48 | 10000 | 1 | 3D894AAB | 80000000 | 3D8949C3 | 80000000
3CFB4BBB | 80000000 | 95CB | 0 | 3CFB4D04 | 80000000 | 1BD5 | 10000 | 1 | 3CFB4AAB | 80000000 | 3CFB4BEF | 80000000
3CFB4BBC | 80000000 | 95CC | 10000 | 3CFB4D05 | 80000000 | 1BD6 | 0 | 1 | 3CFB4CCD | 80000000 | 3CFB4E1A | 80000000
3C5E0DDD | 80000000 | 4C16 | 10000 | 3C5E0E1A | 80000000 | 1D35A | 0 | 1 | 3C5E0CCD | 80000000 | 3C5E0D04 | 80000000
3C5E0DDE | 80000000 | 4C17 | 0 | 3C5E0E1B | 80000000 | 1D35B | 10000 | 1 | 3C5E0EEF | 80000000 | 3C5E0F30 | 80000000
3BBA3AAA | 80000000 | 1FF4B | 0 | 3BBA3BA9 | 80000000 | 187D7 | 10000 | 1 | 3BBA399A | 80000000 | 3BBA3A94 | 80000000
3BBA3AAB | 80000000 | 1FF4C | 10000 | 3BBA3BAA | 80000000 | 187D8 | 0 | 1 | 3BBA3BBC | 80000000 | 3BBA3CBF | 80000000
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
