MoseychukA/ASDB_INFO/adsbee-adsbee_1090-0.8.0-rc3/adsbee-adsbee_1090-0.8.0-rc3/firmware/common/adsb/nasa_cpr/airborne/benchmarks/local-decoding/airborne_locally_decoded_positions_01.csv

3DDDDEEE | 80000000 | 3DDDDE5F | 80000000 | 1 | 8444 | 10000 | 3DDDDD4A | 80000000
3DDDDEEF | 80000000 | 3DDDDE60 | 80000000 | 0 | 10000 | 0 | 3DDDDDDE | 80000000
3D894999 | 80000000 | 3D8948AD | 80000000 | 1 | 5D47 | 0 | 3D894798 | 80000000
3D89499A | 80000000 | 3D8948AE | 80000000 | 0 | D85A | 10000 | 3D894889 | 80000000
3CFB4BBB | 80000000 | 3CFB4D04 | 80000000 | 1 | 1BD5 | 10000 | 3CFB4BEF | 80000000
3CFB4BBC | 80000000 | 3CFB4D05 | 80000000 | 0 | 95CC | 10000 | 3CFB4CCD | 80000000
3C5E0DDD | 80000000 | 3C5E0E1A | 80000000 | 1 | 1D35A | 0 | 3C5E0D04 | 80000000
3C5E0DDE | 80000000 | 3C5E0E1B | 80000000 | 0 | 4C17 | 0 | 3C5E0EEF | 80000000
3BBA3AAA | 80000000 | 3BBA3BA9 | 80000000 | 1 | 187D7 | 10000 | 3BBA3A94 | 80000000
3BBA3AAB | 80000000 | 3BBA3BAA | 80000000 | 0 | 1FF4C | 10000 | 3BBA3BBC | 80000000
3B12CBBB | 80000000 | 3B12CAD8 | 80000000 | 1 | 13AA9 | 0 | 3B12C9C3 | 80000000
3B12CBBC | 80000000 | 3B12CAD9 | 80000000 | 0 | 1B0CF | 10000 | 3B12CAAB | 80000000
3A690DDD | 80000000 | 3A690E1A | 80000000 | 1 | EC6C | 10000 | 3A690D04 | 80000000
3A690DDE | 80000000 | 3A690E1B | 80000000 | 0 | 1613F | 10000 | 3A690EEF | 80000000
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
