MoseychukA/ASDB_INFO/adsbee-adsbee_1090-0.8.0-rc3/adsbee-adsbee_1090-0.8.0-rc3/firmware/common/adsb/nasa_cpr/coarse/benchmarks/encoding/t6-5awb.csv

0 | 3DDDFFFF | 80000000 | 800 | 0
0 | 3DDE0000 | 80000000 | 801 | 800
0 | 3D893333 | 80000000 | 6C2 | 800
0 | 3D893334 | 80000000 | 6C3 | 0
0 | 3CFB5555 | 80000000 | 4AE | 0
0 | 3CFB5556 | 80000000 | 4AF | 800
0 | 3C5DFFFF | 80000000 | 260 | 800
0 | 3C5E0000 | 80000000 | 261 | 0
0 | 3BBA4444 | 80000000 | FFA | 0
0 | 3BBA4445 | 80000000 | FFB | 800
0 | 3B12CCCC | 80000000 | D86 | 800
0 | 3B12CCCD | 80000000 | D87 | 0
0 | 3A68EEEE | 80000000 | B09 | 0
0 | 3A68EEEF | 80000000 | B0A | 800
0 | 39BDBBBB | 80000000 | 887 | 800
0 | 39BDBBBC | 80000000 | 888 | 0
0 | 3910EEEE | 80000000 | 5FF | 0
0 | 3910EEEF | 80000000 | 600 | 800
0 | 38631111 | 80000000 | 373 | 800
0 | 38631112 | 80000000 | 374 | 0
0 | 37B42222 | 80000000 | E3 | 0
0 | 37B42223 | 80000000 | E4 | 800
0 | 37046666 | 80000000 | E50 | 800
0 | 37046667 | 80000000 | E51 | 0
0 | 36539999 | 80000000 | BB9 | 0
0 | 3653999A | 80000000 | BBA | 800
0 | 35A1FFFF | 80000000 | 91F | 800
0 | 35A20000 | 80000000 | 920 | 0
0 | 34EF1111 | 80000000 | 680 | 0
0 | 34EF1112 | 80000000 | 681 | 800
0 | 343B9999 | 80000000 | 3DF | 800
0 | 343B999A | 80000000 | 3E0 | 0
0 | 3386CCCC | 80000000 | 139 | 0
0 | 3386CCCD | 80000000 | 13A | 800
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
