MoseychukA/ASDB_INFO/adsbee-adsbee_1090-0.8.0-rc3/adsbee-adsbee_1090-0.8.0-rc3/firmware/common/adsb/nasa_cpr/coarse/benchmarks/encoding/t6-6awb.csv

1 | 3DDDF752 | 80000000 | 422 | 800
1 | 3DDDF753 | 80000000 | 423 | 800
1 | 3D895B1E | 80000000 | 2EA | 0
1 | 3D895B1F | 80000000 | 2EB | 800
1 | 3CFB4115 | 80000000 | DE | 800
1 | 3CFB4116 | 80000000 | DF | 0
1 | 3C5DF752 | 80000000 | E9A | 0
1 | 3C5DF753 | 80000000 | E9B | 800
1 | 3BBA2B63 | 80000000 | C3E | 800
1 | 3BBA2B64 | 80000000 | C3F | 0
1 | 3B12D8F2 | 80000000 | 9D5 | 0
1 | 3B12D8F3 | 80000000 | 9D6 | 800
1 | 3A6915B1 | 80000000 | 763 | 800
1 | 3A6915B2 | 80000000 | 764 | 0
1 | 39BDB1E5 | 80000000 | 4EB | 0
1 | 39BDB1E6 | 80000000 | 4EC | 800
1 | 3910F2FB | 80000000 | 26E | 800
1 | 3910F2FC | 80000000 | 26F | 0
1 | 38631E5F | 80000000 | FED | 0
1 | 38631E60 | 80000000 | FEE | 800
1 | 37B43411 | 80000000 | D68 | 800
1 | 37B43412 | 80000000 | D69 | 0
1 | 3704797D | 80000000 | AE0 | 0
1 | 3704797E | 80000000 | AE1 | 800
1 | 3653A938 | 80000000 | 854 | 800
1 | 3653A939 | 80000000 | 855 | 0
1 | 35A1C341 | 80000000 | 5C4 | 0
1 | 35A1C342 | 80000000 | 5C5 | 800
1 | 34EF5270 | 80000000 | 332 | 800
1 | 34EF5271 | 80000000 | 333 | 0
1 | 343B8682 | 80000000 | 9B | 0
1 | 343B8683 | 80000000 | 9C | 800
1 | 3386A4E1 | 80000000 | E00 | 800
1 | 3386A4E2 | 80000000 | E01 | 0
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
