MoseychukA/ASDB_INFO/adsbee-adsbee_1090-0.8.0-rc3/adsbee-adsbee_1090-0.8.0-rc3/firmware/common/adsb/nasa_cpr/coarse/benchmarks/global-decoding/coarse_globally_decoded_positions_01.csv

3D893333 | 80000000 | 6C2 | 800 | 3D893334 | 80000000 | 2EA | 0 | 1 | 3D891111 | 80000000 | 3D893868 | 80000000
3B12CCCC | 80000000 | D86 | 800 | 3B12CCCD | 80000000 | 9D5 | 0 | 1 | 3B12AAAB | 80000000 | 3B12B63D | 80000000
3A68EEEE | 80000000 | B09 | 0 | 3A68EEEF | 80000000 | 763 | 800 | 1 | 3A68CCCD | 80000000 | 3A68F2FC | 80000000
3910EEEE | 80000000 | 5FF | 0 | 3910EEEF | 80000000 | 26E | 800 | 1 | 3910CCCD | 80000000 | 3910D045 | 80000000
38631111 | 80000000 | 373 | 800 | 38631112 | 80000000 | FED | 0 | 1 | 3862EEEF | 80000000 | 3862FBA9 | 80000000
37B42222 | 80000000 | E3 | 0 | 37B42223 | 80000000 | D68 | 800 | 1 | 37B40000 | 80000000 | 37B4115B | 80000000
37046666 | 80000000 | E50 | 800 | 37046667 | 80000000 | AE0 | 0 | 1 | 37044444 | 80000000 | 370456C8 | 80000000
36539999 | 80000000 | BB9 | 0 | 3653999A | 80000000 | 854 | 800 | 1 | 36537777 | 80000000 | 36538682 | 80000000
34EF1111 | 80000000 | 680 | 0 | 34EF1112 | 80000000 | 332 | 800 | 1 | 34EEEEEF | 80000000 | 34EF2FBB | 80000000
32D0EEEE | 80000000 | E8F | 800 | 32D0EEEF | 80000000 | B62 | 0 | 1 | 32D0CCCD | 80000000 | 32D0D045 | 80000000
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
