MoseychukA/ASDB_INFO/adsbee-adsbee_1090-0.8.0-rc3/adsbee-adsbee_1090-0.8.0-rc3/firmware/common/adsb/nasa_cpr/coarse/benchmarks/local-decoding/coarse_locally_decoded_positions_01.csv

3DDDFFFF | 80000000 | 3DDE0000 | 80000000 | 1 | 423 | 800 | 3DDE1A09 | 80000000
3D893333 | 80000000 | 3D893334 | 80000000 | 0 | 6C3 | 0 | 3D895555 | 80000000
3CFB5555 | 80000000 | 3CFB5556 | 80000000 | 1 | DF | 0 | 3CFB63CC | 80000000
3C5DFFFF | 80000000 | 3C5E0000 | 80000000 | 0 | 261 | 0 | 3C5E2222 | 80000000
3BBA4444 | 80000000 | 3BBA4445 | 80000000 | 1 | C3F | 0 | 3BBA4E1A | 80000000
3B12CCCC | 80000000 | 3B12CCCD | 80000000 | 0 | D87 | 0 | 3B12EEEF | 80000000
3A68EEEE | 80000000 | 3A68EEEF | 80000000 | 1 | 763 | 800 | 3A68F2FC | 80000000
39BDBBBB | 80000000 | 39BDBBBC | 80000000 | 0 | 888 | 0 | 39BDDDDE | 80000000
3910EEEE | 80000000 | 3910EEEF | 80000000 | 1 | 26E | 800 | 3910D045 | 80000000
38631111 | 80000000 | 38631112 | 80000000 | 0 | 374 | 0 | 38633333 | 80000000
37B42222 | 80000000 | 37B42223 | 80000000 | 1 | D68 | 800 | 37B4115B | 80000000
37046666 | 80000000 | 37046667 | 80000000 | 0 | E51 | 0 | 37048889 | 80000000
36539999 | 80000000 | 3653999A | 80000000 | 1 | 854 | 800 | 36538682 | 80000000
35A1FFFF | 80000000 | 35A20000 | 80000000 | 0 | 920 | 0 | 35A22222 | 80000000
34EF1111 | 80000000 | 34EF1112 | 80000000 | 1 | 332 | 800 | 34EF2FBB | 80000000
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
