MoseychukA/ASDB_INFO/adsbee-adsbee_1090-0.8.0-rc3/adsbee-adsbee_1090-0.8.0-rc3/firmware/common/adsb/nasa_cpr/surface/benchmarks/global-decoding/surface_globally_decoded_positions_01.csv

3DDDDE22 | 20000000 | 0 | 0 | 3DDDDE1A | 20000000 | 1111 | 10000 | 1 | 3DDDDDDE | 20000000 | 3DDDDDD5 | 20000000
3DDDDE23 | 20000000 | 1 | 10000 | 3DDDDE1B | 20000000 | 1112 | 10000 | 1 | 3DDDDE66 | 20000000 | 3DDDDE5F | 20000000
3D8948CC | 20000000 | 16168 | 10000 | 3D894868 | 20000000 | 1751D | 0 | 1 | 3D894889 | 20000000 | 3D894823 | 20000000
3D8948CD | 20000000 | 16169 | 0 | 3D894869 | 20000000 | 1751E | 10000 | 1 | 3D894911 | 20000000 | 3D8948AE | 20000000
3CFB4BFF | 20000000 | 572E | 0 | 3CFB4C34 | 20000000 | 6F54 | 10000 | 1 | 3CFB4BBC | 20000000 | 3CFB4BEF | 20000000
3CFB4C00 | 20000000 | 572F | 10000 | 3CFB4C35 | 20000000 | 6F55 | 0 | 1 | 3CFB4C44 | 20000000 | 3CFB4C79 | 20000000
3C5E0E22 | 20000000 | 1305A | 10000 | 3C5E0E5F | 20000000 | 14D6A | 0 | 1 | 3C5E0DDE | 20000000 | 3C5E0E1A | 20000000
3C5E0E23 | 20000000 | 1305B | 0 | 3C5E0E60 | 20000000 | 14D6B | 10000 | 1 | 3C5E0E66 | 20000000 | 3C5E0EA5 | 20000000
3BBA3A66 | 20000000 | 1FD2D | 0 | 3BBA3AD8 | 20000000 | 1F5C | 10000 | 1 | 3BBA3A22 | 20000000 | 3BBA3A94 | 20000000
3BBA3A67 | 20000000 | 1FD2E | 10000 | 3BBA3AD9 | 20000000 | 1F5D | 0 | 1 | 3BBA3AAB | 20000000 | 3BBA3B1E | 20000000
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
