MoseychukA/ASDB_INFO/adsbee-adsbee_1090-0.8.0-rc3/adsbee-adsbee_1090-0.8.0-rc3/firmware/common/adsb/nasa_cpr/surface/benchmarks/local-decoding/surface_locally_decoded_positions_01.csv

3DDDDE22 | 20000000 | 3DDDDE1A | 20000000 | 1 | 1111 | 10000 | 3DDDDDD5 | 20000000
3DDDDE23 | 20000000 | 3DDDDE1B | 20000000 | 0 | 0 | 0 | 3DDDDDDE | 20000000
3D8948CC | 20000000 | 3D894868 | 20000000 | 1 | 1751D | 0 | 3D894823 | 20000000
3D8948CD | 20000000 | 3D894869 | 20000000 | 0 | 16168 | 10000 | 3D894889 | 20000000
3CFB4BFF | 20000000 | 3CFB4C34 | 20000000 | 1 | 6F54 | 10000 | 3CFB4BEF | 20000000
3CFB4C00 | 20000000 | 3CFB4C35 | 20000000 | 0 | 572F | 10000 | 3CFB4C44 | 20000000
3C5E0E22 | 20000000 | 3C5E0E5F | 20000000 | 1 | 14D6A | 0 | 3C5E0E1A | 20000000
3C5E0E23 | 20000000 | 3C5E0E60 | 20000000 | 0 | 1305B | 0 | 3C5E0E66 | 20000000
3BBA3A66 | 20000000 | 3BBA3AD8 | 20000000 | 1 | 1F5C | 10000 | 3BBA3A94 | 20000000
3BBA3A67 | 20000000 | 3BBA3AD9 | 20000000 | 0 | 1FD2E | 10000 | 3BBA3AAB | 20000000
3B12CB77 | 20000000 | 3B12CBA9 | 20000000 | 1 | EAA7 | 0 | 3B12CB64 | 20000000
3B12CB78 | 20000000 | 3B12CBAA | 20000000 | 0 | C33E | 0 | 3B12CBBC | 20000000
3A690D99 | 20000000 | 3A690D49 | 20000000 | 1 | 1B1B0 | 10000 | 3A690D04 | 20000000
3A690D9A | 20000000 | 3A690D4A | 20000000 | 0 | 184F9 | 0 | 3A690D55 | 20000000
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
