MoseychukA/ASDB_INFO/adsbee-adsbee_1090-0.8.0-rc3/adsbee-adsbee_1090-0.8.0-rc3/firmware/common/adsb/nasa_cpr/surface/benchmarks/encoding/MOPS-table-2-140.csv

10.470463 | 077216EF | 10.470474 | 07721777 | 1F5EB | 10000 | 1F5EC | 00000
14.828167 | 0A8B62AB | 14.828178 | 0A8B6333 | 1C559 | 00000 | 1C55A | 10000
18.186253 | 0CEEB4CD | 18.186264 | 0CEEB555 | 03F93 | 10000 | 03F94 | 00000
21.029388 | 0EF44889 | 21.029400 | 0EF44911 | 00A08 | 00000 | 00A09 | 10000
23.545040 | 10BE3E66 | 23.545052 | 10BE3EEF | 164B5 | 10000 | 164B6 | 00000
25.829247 | 125E1222 | 25.829258 | 125E12AB | 07062 | 00000 | 07063 | 10000
27.938976 | 13DE22AB | 27.938988 | 13DE2333 | 14081 | 10000 | 14082 | 00000
29.911354 | 15453222 | 29.911366 | 154532AB | 1E1BE | 00000 | 1E1BF | 10000
31.772095 | 1697EEEF | 31.772106 | 1697EF77 | 05CE0 | 10000 | 05CE1 | 00000
33.539932 | 17D9C222 | 33.539944 | 17D9C2AB | 0B84C | 00000 | 0B84D | 10000
35.228989 | 190D3DDE | 35.229000 | 190D3E66 | 0F8D4 | 10000 | 0F8D5 | 00000
36.850250 | 1A346222 | 36.850262 | 1A3462AB | 12238 | 00000 | 12239 | 10000
38.412415 | 1B50C444 | 38.412426 | 1B50C4CD | 13770 | 10000 | 13771 | 00000
39.922565 | 1C63AE66 | 39.922577 | 1C63AEEF | 13AE7 | 00000 | 13AE8 | 10000
41.386517 | 1D6E2F77 | 41.386528 | 1D6E3000 | 12E99 | 10000 | 12E9A | 00000
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
