MoseychukA/ASDB_INFO/adsbee-adsbee_1090-0.8.0-rc3/adsbee-adsbee_1090-0.8.0-rc3/firmware/common/adsb/nasa_cpr/surface/benchmarks/encoding/MOPS-table-2-141.csv

0 | C0000000 | 80000000 | 00000 | 00000
1 | C0000000 | 80000000 | 00000 | 00000
0 | C0091A2B | 7FA4FA50 | 01111 | 1FD28
1 | C0091A2B | 7FA4FA50 | 010C8 | 1FD28
0 | C05B05B0 | 7EEEEEEF | 0AAAB | 1F777
1 | C05B05B0 | 7EEEEEEF | 0A7D2 | 1F777
0 | C0B60B61 | 7CCCCCCD | 15555 | 1E666
1 | C0B60B61 | 7CCCCCCD | 14FA5 | 1E666
0 | C1C71C72 | 8AAAAAAB | 15555 | 05555
1 | C1C71C72 | 8AAAAAAB | 1471C | 05555
0 | C24FA4FA | 860B60B6 | 05555 | 060B6
1 | C24FA4FA | 860B60B6 | 042D8 | 0305B
0 | C27D27D2 | 85555555 | 0AAAB | 08000
1 | C27D27D2 | 85555555 | 096C1 | 05555
0 | C2F37C05 | 2EC16C17 | 18889 | 06222
1 | C2F37C05 | 2EC16C17 | 170ED | 0EC17
0 | C38E38E4 | 9A7D27D2 | 0AAAB | 14FA5
1 | C38E38E4 | 9A7D27D2 | 08E39 | 07BBC
0 | C416C16C | 2AAAAAAB | 1AAAB | 0AAAB
1 | C416C16C | 2AAAAAAB | 189F5 | 15555
0 | C4962FC9 | D5555555 | 0999A | 00000
1 | C4962FC9 | D5555555 | 074E8 | 15555
0 | C53490BA | 55555555 | 1C28F | 0AAAB
1 | C53490BA | 55555555 | 198EB | 00000
0 | C5DDDDDE | AAAAAAAB | 10000 | 0AAAB
1 | C5DDDDDE | AAAAAAAB | 0D111 | 15555
0 | C6EEEEEF | 66666666 | 10000 | 0CCCD
1 | C6EEEEEF | 66666666 | 0C889 | 1999A
0 | C749F49F | 9999999A | 1AAAB | 00000
1 | C749F49F | 9999999A | 1705B | 13333
0 | C83FB72F | A9F49F4A | 17777 | 06C17
1 | C83FB72F | A9F49F4A | 1357A | 11C72
0 | C8F5C28F | 560B60B6 | 0CCCD | 04444
1 | C8F5C28F | 560B60B6 | 0851F | 193E9
0 | C9907F6E | 924A2EE0 | 1EEEF | 16E23
1 | C9907F6E | 924A2EE0 | 1A26B | 0DBD2
0 | CA3D70A4 | 6DB5D120 | 13333 | 1FF8B
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
1 | 03A06D3A | 0471C71C | 0AFC9 | 00E39
0 | 01C71C72 | 6DB5D120 | 15555 | 0473A
1 | 01C71C72 | 6DB5D120 | 1471C | 0D98B
0 | 00000000 | 2AAAAAAB | 00000 | 0AAAB
1 | 00000000 | 2AAAAAAB | 00000 | 15555
0 | 00000000 | 90000000 | 00000 | 18000
1 | 00000000 | 90000000 | 00000 | 10000
