MoseychukA/ASDB_INFO/adsbee-adsbee_1090-0.8.0-rc3/adsbee-adsbee_1090-0.8.0-rc3/firmware/common/adsb/nasa_cpr/surface/benchmarks/encoding/t6-1awb.csv

0 | 3DDDDE22 | 20000000 | 0 | 0
0 | 3DDDDE23 | 20000000 | 1 | 10000
0 | 3D8948CC | 20000000 | 16168 | 10000
0 | 3D8948CD | 20000000 | 16169 | 0
0 | 3CFB4BFF | 20000000 | 572E | 0
0 | 3CFB4C00 | 20000000 | 572F | 10000
0 | 3C5E0E22 | 20000000 | 1305A | 10000
0 | 3C5E0E23 | 20000000 | 1305B | 0
0 | 3BBA3A66 | 20000000 | 1FD2D | 0
0 | 3BBA3A67 | 20000000 | 1FD2E | 10000
0 | 3B12CB77 | 20000000 | C33D | 10000
0 | 3B12CB78 | 20000000 | C33E | 0
0 | 3A690D99 | 20000000 | 184F9 | 0
0 | 3A690D9A | 20000000 | 184FA | 10000
0 | 39BDA599 | 20000000 | 4396 | 10000
0 | 39BDA59A | 20000000 | 4397 | 0
0 | 3910ED11 | 20000000 | FFBC | 0
0 | 3910ED12 | 20000000 | FFBD | 10000
0 | 38631599 | 20000000 | 1B9C8 | 10000
0 | 3863159A | 20000000 | 1B9C9 | 0
0 | 37B438CC | 20000000 | 71EA | 0
0 | 37B438CD | 20000000 | 71EB | 10000
0 | 37046511 | 20000000 | 1283D | 10000
0 | 37046512 | 20000000 | 1283E | 0
0 | 36539F33 | 20000000 | 1DCCA | 0
0 | 36539F34 | 20000000 | 1DCCB | 10000
0 | 35A1E511 | 20000000 | 8F8D | 10000
0 | 35A1E512 | 20000000 | 8F8E | 0
0 | 34EF31DD | 20000000 | 1407D | 0
0 | 34EF31DE | 20000000 | 1407E | 10000
0 | 343B7C88 | 20000000 | 1EF89 | 10000
0 | 343B7C89 | 20000000 | 1EF8A | 0
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
