MoseychukA/ASDB_INFO/adsbee-adsbee_1090-0.8.0-rc3/adsbee-adsbee_1090-0.8.0-rc3/firmware/common/adsb/nasa_cpr/surface/benchmarks/encoding/t6-2awb.csv

1 | 3DDDDE1A | 20000000 | 1111 | 10000
1 | 3DDDDE1B | 20000000 | 1112 | 10000
1 | 3D894868 | 20000000 | 1751D | 0
1 | 3D894869 | 20000000 | 1751E | 10000
1 | 3CFB4C34 | 20000000 | 6F54 | 10000
1 | 3CFB4C35 | 20000000 | 6F55 | 0
1 | 3C5E0E5F | 20000000 | 14D6A | 0
1 | 3C5E0E60 | 20000000 | 14D6B | 10000
1 | 3BBA3AD8 | 20000000 | 1F5C | 10000
1 | 3BBA3AD9 | 20000000 | 1F5D | 0
1 | 3B12CBA9 | 20000000 | EAA7 | 0
1 | 3B12CBAA | 20000000 | EAA8 | 10000
1 | 3A690D49 | 20000000 | 1B1B0 | 10000
1 | 3A690D4A | 20000000 | 1B1B1 | 0
1 | 39BDA5B1 | 20000000 | 75A9 | 0
1 | 39BDA5B2 | 20000000 | 75AA | 10000
1 | 3910ED49 | 20000000 | 13735 | 10000
1 | 3910ED4A | 20000000 | 13736 | 0
1 | 3863156C | 20000000 | 1F6AF | 0
1 | 3863156D | 20000000 | 1F6B0 | 10000
1 | 37B438AD | 20000000 | B448 | 10000
1 | 37B438AE | 20000000 | B449 | 0
1 | 37046527 | 20000000 | 1701A | 0
1 | 37046528 | 20000000 | 1701B | 10000
1 | 36539F2F | 20000000 | 2A2D | 10000
1 | 36539F30 | 20000000 | 2A2E | 0
1 | 35A1E527 | 20000000 | E27E | 0
1 | 35A1E528 | 20000000 | E27F | 10000
1 | 34EF31A0 | 20000000 | 19903 | 10000
1 | 34EF31A1 | 20000000 | 19904 | 0
1 | 343B7D04 | 20000000 | 4DAE | 0
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
