MoseychukA/ASDB_INFO/adsbee-adsbee_1090-0.8.0-rc3/adsbee-adsbee_1090-0.8.0-rc3/kicad/adsbee_1090/adsbee_1090.pdf

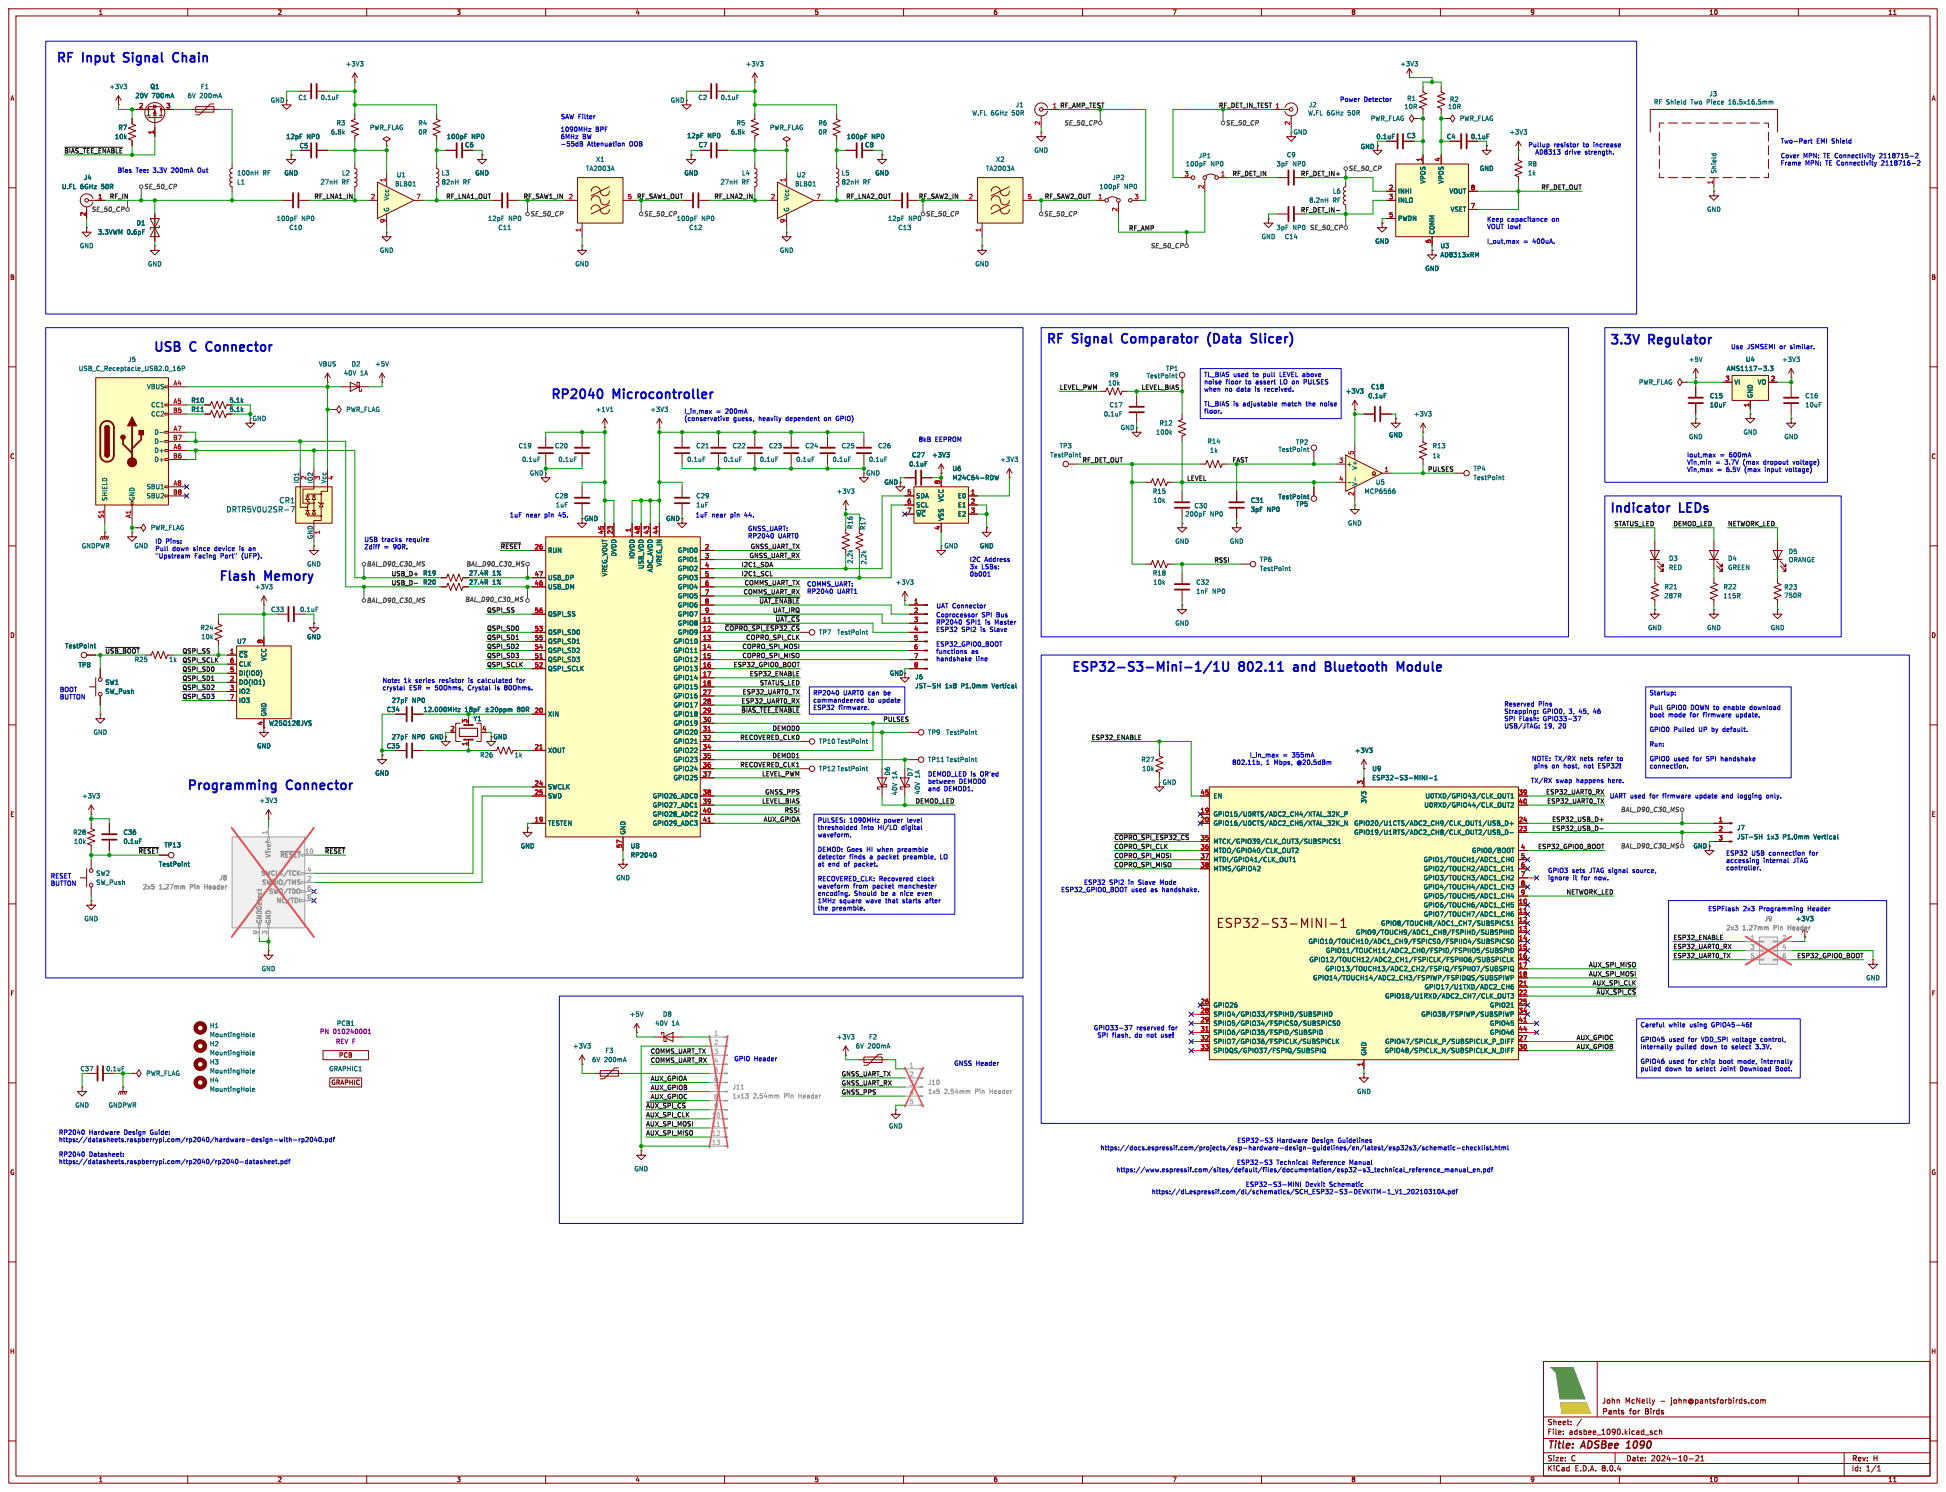
[picture p53: page 1]

RF Input Signal Chain

J3 RF Shield Two Piece 16.5x16.5mm

RF Signal Comparator (Data Slicer)

TL_BIAS used to pull LEVEL above

1 GPIO8 11 GPIO9 12 GPIO10 13 GPIO11 14 GPIO12 15 GPIO13 16 GPIO14 17 GPIO15 18 TESTEN 19 GPIO0 2 XIN 20 XOUT 21 DVDD 23 SWCLK 24 SWD 25 RUN 26 GPIO16 27 GPIO17 28 GPIO18 29 GPIO1 3 GPIO19 30 GPIO20 31 GPIO21 32 GPIO22 34 GPIO23 35 GPIO24 36 GPIO25 37 GPIO26_ADC0 38 GPIO27_ADC1 39 GPIO2 4 GPIO28_ADC2 40 GPIO29_ADC3 41 ADC_AVDD 43 VREG_IN 44 VREG_VOUT 45 USB_DM 46 USB_DP 47 USB_VDD 48 GPIO3 5 QSPI_SD3 51 QSPI_SCLK 52 QSPI_SD0 53 QSPI_SD2 54 QSPI_SD1 55 QSPI_SS 56 GND 57 GPIO4 6 GPIO5 7 GPIO6 8 GPIO7 9 +3V3 GND

Vin,min = 3.7V (max dropout voltage) Vin,max = 6.5V (max input voltage)

JST-SH 1x3 P1.0mm Vertical GND GND1 IO12IO23Vcc4 CR1

4 SDA 5 SCL 6 ~{WC} 7 VCC

PWR_FLAG
ID Pins: Pull down since device is an

1 GPIO8 11 GPIO9 12 GPIO10 13 GPIO11 14 GPIO12 15 GPIO13 16 GPIO14 17 GPIO15 18 TESTEN 19 GPIO0 2 XIN 20 XOUT 21 DVDD 23 SWCLK 24 SWD 25 RUN 26 GPIO16 27 GPIO17 28 GPIO18 29 GPIO1 3 GPIO19 30 GPIO20 31 GPIO21 32 GPIO22 34 GPIO23 35 GPIO24 36 GPIO25 37 GPIO26_ADC0 38 GPIO27_ADC1 39 GPIO2 4 GPIO28_ADC2 40 GPIO29_ADC3 41 ADC_AVDD 43 VREG_IN 44 VREG_VOUT 45 USB_DM 46 USB_DP 47 USB_VDD 48 GPIO3 5 QSPI_SD3 51 QSPI_SCLK 52 QSPI_SD0 53 QSPI_SD2 54 QSPI_SD1 55 QSPI_SS 56 GND 57 GPIO4 6 GPIO5 7 GPIO6 8 GPIO7 9 U8 RP2040 GND

JST-SH 1x8 P1.0mm Vertical GND

NOTE: TX/RX nets refer to
pins on host, not ESP32! TX/RX swap happens here.
40 GPIO45
24 GPIO21

3 SWCLK/TCK 4 SWO/TDO 6 NC/TDI 8 GNDDetect 9 C36

3 SWCLK/TCK 4 SWO/TDO 6 NC/TDI 8 GNDDetect 9

GPIO3 sets JTAG signal source,

1MHz square wave that starts after
the preamble.

Careful while using GPIO45-46! GPIO45 used for VDD_SPI voltage control,

pulled down to select Joint Download Boot.

RP2040 Hardware Design Guide: https://datasheets.raspberrypi.com/rp2040/hardware-design-with-rp2040.pdf RP2040 Datasheet: https://datasheets.raspberrypi.com/rp2040/rp2040-datasheet.pdf
