MoseychukA/ASDB_INFO/adsbee-0.0.1/adsbee-0.0.1/ltspice/bandpass_ac.asc

C1: cap; 12p
C2: cap; 4p
C3: cap; 0.01p
C4: cap; 2p
C5: cap; 1.378p
L1: ind; 6.8n
L2: ind; 6.8n
R1: res; 50
R2: res; 760
V1: voltage; ""; AC 1
Named nets: 0, in, out
.ac dec 1000 500Meg 2G
