MoseychukA/ASDB_INFO/adsbee-0.0.1/adsbee-0.0.1/ltspice/hysteresis_comparator.asc

C1: cap; 0.1µ; IC=v_mtl
C2: cap; 22n
D1: diode; 1N4148
M1: pmos; BSS84
R1: res; 10k
R2: res; 115
R3: res; 10k
R7: res; 1k
S1: sw; SN74LVC1G3157
S2: sw; SN74LVC1G3157
U1: UniversalOpAmp2; Avol=1Meg GBW=10G Slew=10G
U2: UniversalOpAmp2; Avol=1Meg GBW=10G Slew=10G
V1: voltage; PULSE(0 {v_dd} 0 10n 10n {t_on} {t_period})
V2: voltage; PULSE(2.2 1.8 0 100n 100n 0.5u 1u)
V3: voltage; {v_dd}
V4: voltage; 2.0
V5: voltage; PULSE(3.3 0 65u 1n 1n 10u 1000u)
Named nets: 0, in, 3v3, mtl_hi, mtl_lo, _rssi_clear, rssi_hold
RC Lowpass f_c=159Hz
.param f_sw=25k v_mtl=1.9 v_dd=3.3 t_period={1/f_sw} t_on={v_mtl/v_dd*t_period} t_off={1-t_on}
.tran 0 1m 0 10n
The big danger is that out could pull mtl up too far!
.model custom_zener ako: 1N750 bv=2.2
.model SN74LVC1G3157 SW(Ron=6 Roff=1G Vt=1.65 Vh=0.66)
