MoseychukA/ASDB_INFO/adsbee-0.0.1/adsbee-0.0.1/ltspice/rf_det_out_amp.asc

C1: cap; 0.1µ
R1: res; 1k
R2: res; 10k
R3: res; 100k
U1: UniversalOpAmp2; Avol=1Meg GBW=100Meg Slew=150Meg
V1: voltage; PULSE(2.1 2 2u 1n 1n 500n 1u)
V2: voltage; 3.3
Named nets: 3v3, 0, out, in
TLV3542IDR
.tran 10u
