MoseychukA/ASDB_INFO/adsbee-0.0.1/adsbee-0.0.1/ltspice/rf_det_out_amp_bodge.asc

C1: cap; 22n
C2: cap; 10p
C3: cap; 1p
R1: res; 10k
R2: res; 100k
R3: res; 10k
R4: res; 20k
R5: res; 20k
R6: res; 5.1k
U1: UniversalOpAmp2; Avol=1Meg GBW=80Meg Slew=55Meg
V1: voltage; PULSE(2.1 2 2u 1n 1n 500n 1u)
V2: voltage; 3.3
V3: voltage; SINE(0 0.1 100Meg)
Named nets: 3v3, 0, out, in, out_filt
OPA358AIDCKR
.tran 0 10u 0 1n
