MoseychukA/ASDB_INFO/adsbee-0.0.1/adsbee-0.0.1/kicad/proto_ads_bee_rf_board/proto_ads_bee_rf_board.kicad_pcb

## KiCad design adsbee-0.0.1/adsbee-0.0.1/kicad/proto_ads_bee_rf_board/proto_ads_bee_rf_board.kicad_pcb (2025-06-24)

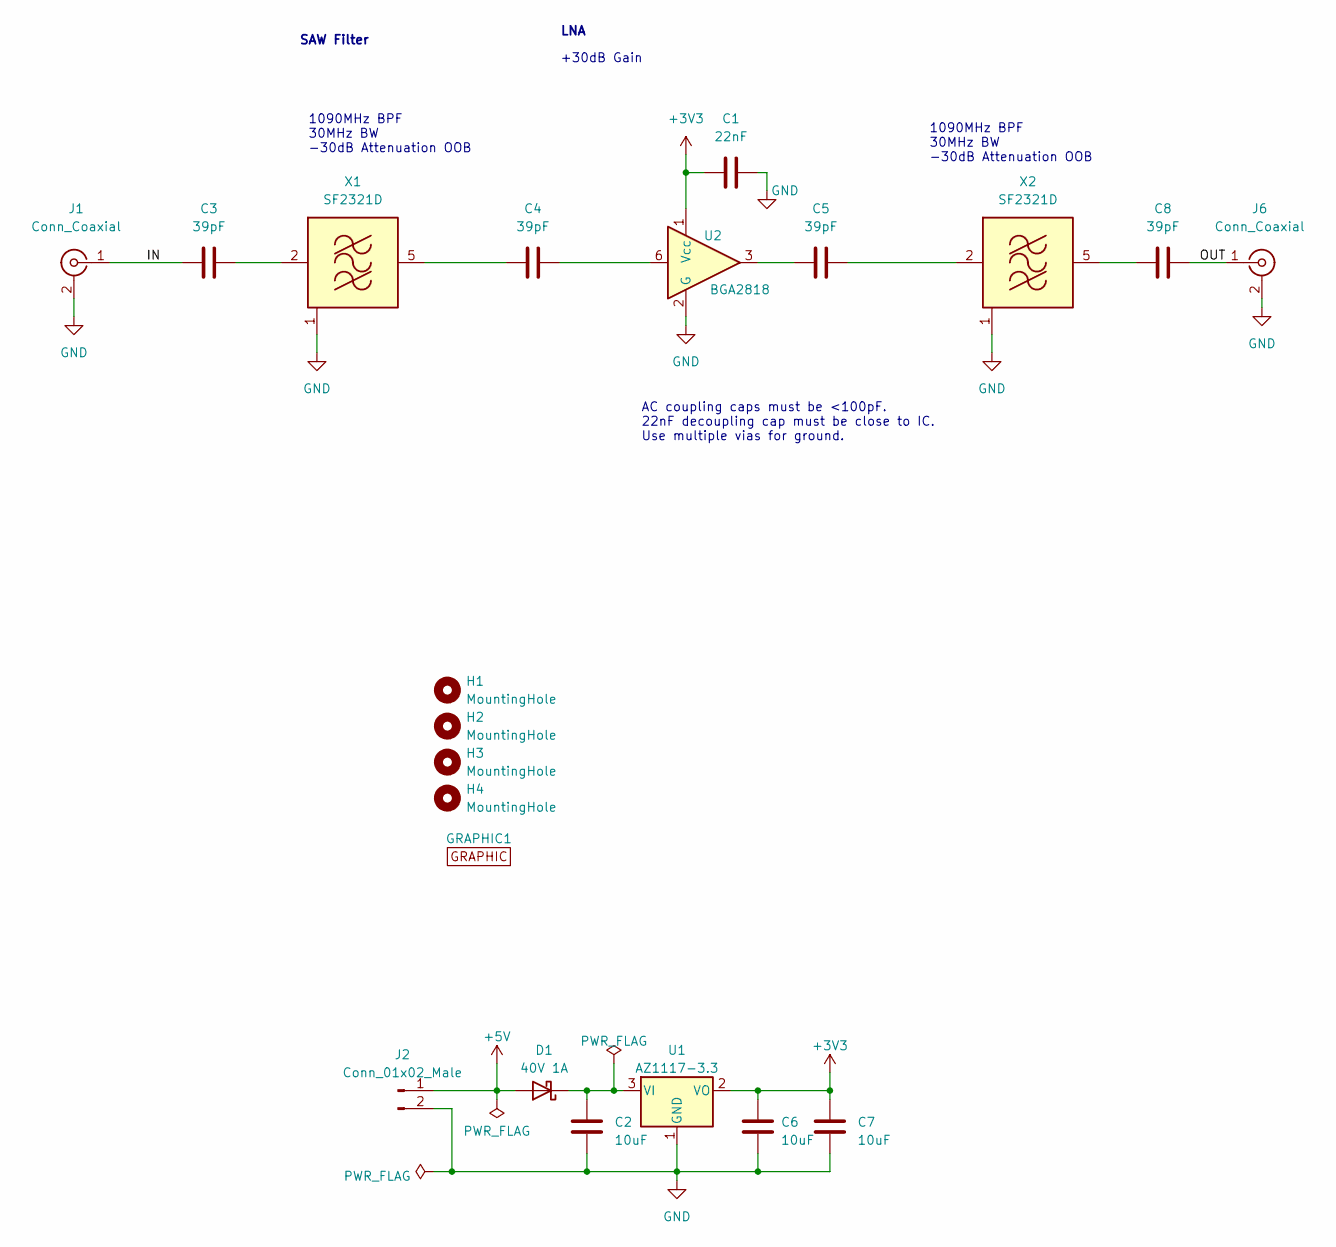
[picture p54: schematic proto_ads_bee_rf_board.kicad_sch]

Parts:
C1: 22nF; C_0603_1608Metric
C2, C6, C7: 10uF; C_0805_2012Metric
C3, C4, C5, C8: 39pF; C_0603_1608Metric
D1: 40V 1A; D_DO-41_SOD81_P7.62mm_Horizontal; MPN 1N5819
GRAPHIC1: Graphic; bird_with_pants_small_flipped
H1, H2, H3, H4: MountingHole; MountingHole_3.2mm_M3
J1, J6: Conn_Coaxial; SMA_Amphenol_132289_EdgeMount; MPN 132289
J2: Conn_01x02_Male; PinHeader_1x02_P2.54mm_Horizontal
U1: AZ1117-3.3; SOT-223-3_TabPin2
U2: BGA2818; SOT-363_SC-70-6
X1, X2: SF2321D; Filter_SAW-6_3.8x3.8mm; MPN SF2321D

Connections:
+3V3: C1.1, C6.1, C7.1, U1.2 (VO), U2.1 (Vcc)
+5V: D1.2 (A), J2.1
/IN: C3.1, J1.1 (In)
/OUT: C8.2, J6.1 (In)
GND: C1.2, C2.2, C6.2, C7.2, J1.2 (Ext), J2.2, J6.2 (Ext), U1.1 (GND), U2.2 (G), U2.4 (G), U2.5 (G), X1.1 (GND), X1.3 (GND), X1.4 (GND), X1.6 (GND), X2.1 (GND), X2.3 (GND), X2.4 (GND), X2.6 (GND)
unnamed: C4.2, U2.6
unnamed: C5.1, U2.3
unnamed: C2.1, D1.1 (K), U1.3 (VI)
unnamed: C3.2, X1.2 (IN)
unnamed: C4.1, X1.5 (OUT)
unnamed: C5.2, X2.2 (IN)
unnamed: C8.1, X2.5 (OUT)

Notes on the sheet:
LNA
+30dB Gain
1090MHz BPF 30MHz BW -30dB Attenuation OOB
SAW Filter
AC coupling caps must be <100pF. 22nF decoupling cap must be close to IC. Use multiple vias for ground.

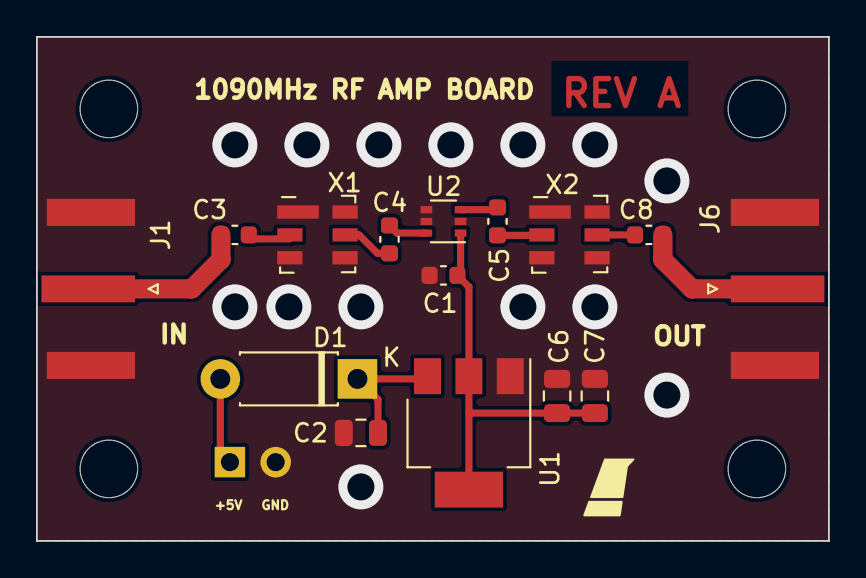
[picture p55: board proto_ads_bee_rf_board.kicad_pcb from above]

Board: 2 copper layers, 44.0 x 28.0 mm, 21 parts (1 on the bottom side), 12 nets.
