MoseychukA/ASDB_INFO/adsbee-0.0.1/adsbee-0.0.1/kicad/proto_ads_bee_mcu_board/proto_ads_bee_mcu_board.kicad_pcb

## KiCad design adsbee-0.0.1/adsbee-0.0.1/kicad/proto_ads_bee_mcu_board/proto_ads_bee_mcu_board.kicad_pcb (2025-06-24)

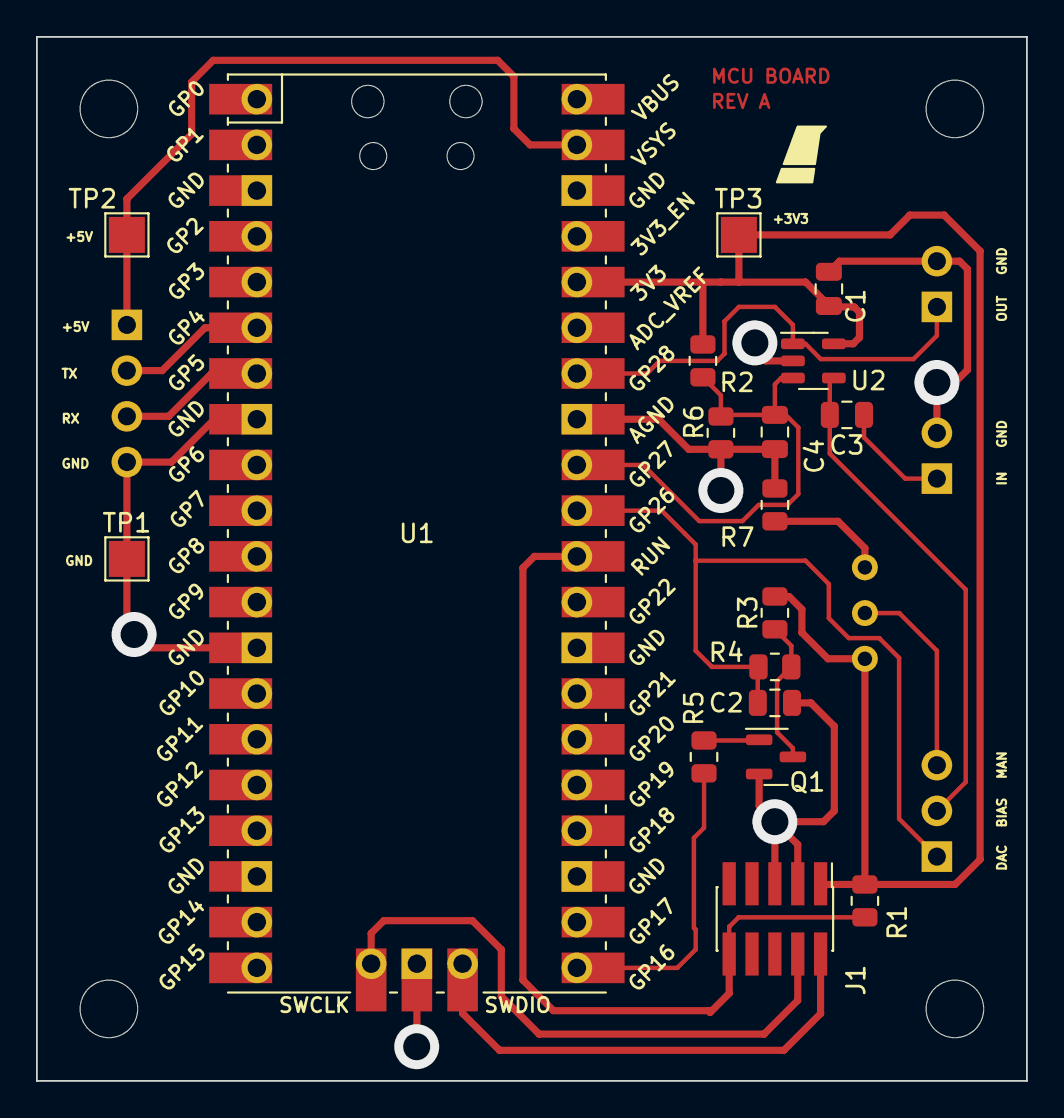
[picture p56: board proto_ads_bee_mcu_board.kicad_pcb from above]

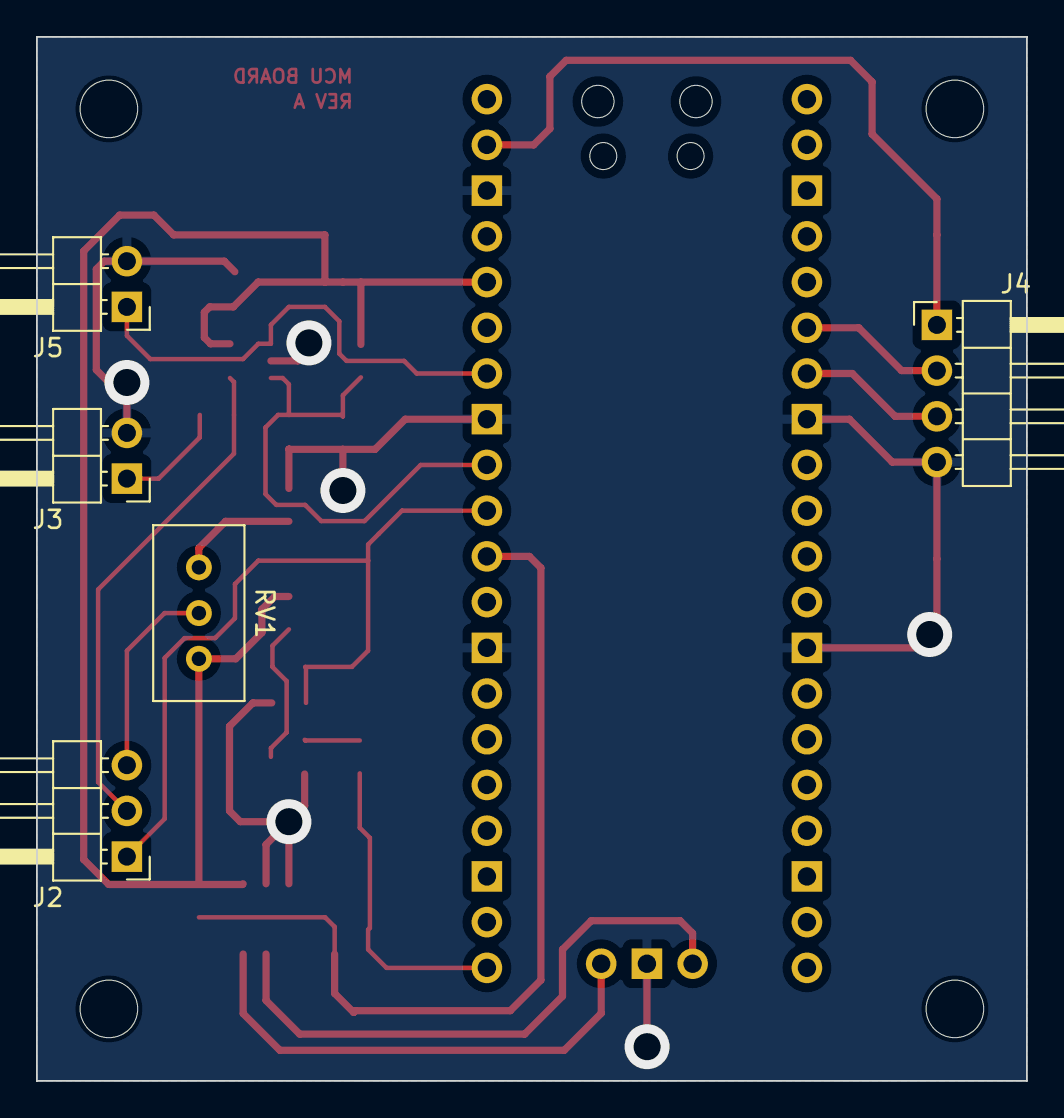
[picture p57: board proto_ads_bee_mcu_board.kicad_pcb from below]

Board: 2 copper layers, 55.0 x 58.0 mm, 29 parts (5 on the bottom side), 18 nets.

Parts:
C1, C2, C4: 0.1uF; C_0805_2012Metric
C3: 1uF; C_0805_2012Metric
GRAPHIC1: Graphic; bird_with_pants_small_flipped
H1, H2, H3, H4: MountingHole; MountingHole_3.2mm_M3
J1: Conn_ARM_JTAG_SWD_10; PinHeader_2x05_P1.27mm_Vertical_SMD
J2: Conn_01x03_Pin; PinHeader_1x03_P2.54mm_Horizontal
J3, J5: Conn_01x02_Pin; PinHeader_1x02_P2.54mm_Horizontal
J4: Conn_01x04_Pin; PinHeader_1x04_P2.54mm_Horizontal
PCB1: PCB; PCB_PN_REV_small
Q1: 2N7002; SOT-23
R1, R2, R4: 10k; R_0805_2012Metric
R3: 1k; R_0805_2012Metric
R5: 100; R_0805_2012Metric
R6, R7: 4.99k; R_0805_2012Metric
RV1: 10k; Potentiometer_Bourns_3296W_Vertical
TP1, TP2, TP3: TestPoint; TestPoint_Pad_2.0x2.0mm
U1: Pico; RPi_Pico_SMD_TH
U2: MCP6541; SOT-23-5

Connections:
+3V3: C1.1, J1.1 (VTref), R1.1, R2.1, R3.1, RV1.1, TP3.1, U1.36 (3V3), U2.5 (V+)
+5V: J4.1, TP2.1, U1.39 (VSYS)
/COMP_BIAS_DC: C2.1, J2.1, R4.2, U1.31 (GPIO26_ADC0)
/COMP_BIAS_PWM: R5.1, U1.21 (GPIO16)
/COMP_OUT: J5.1, U1.34 (GPIO28_ADC2), U2.1
/COMP_REF: C4.1, R2.2, R6.1, U1.32 (GPIO27_ADC1), U2.3 (+)
/COMP_SIG: C3.2, J2.2, U2.4 (-)
/UART_RX: J4.3, U1.7 (GPIO5)
/UART_TX: J4.2, U1.6 (GPIO4)
/V_DN: C3.1, J3.1
/~RESET: J1.10 (~RESET), R1.2, U1.30 (RUN)
GND: C1.2, C2.2, C4.2, J1.3 (GND), J1.5 (GND), J3.2, J4.4, J5.2, Q1.2 (S), R6.2, R7.2, TP1.1, U1.8 (GND), U1.13 (GND), U1.28 (GND), U1.33 (AGND), U1.38 (GND), U1.42 (GND), U2.2 (V-)
unnamed: J1.4 (SWDCLK/TCK), U1.41 (SWCLK)
unnamed: J1.2 (SWDIO/TMS), U1.43 (SWDIO)
unnamed: J2.3, RV1.2
unnamed: Q1.3 (D), R3.2, R4.1
unnamed: Q1.1 (G), R5.2
unnamed: R7.1, RV1.3
