MoseychukA/ASDB_INFO/adsbee-0.0.1/adsbee-0.0.1/kicad/proto_amp_bodge_board/proto_amp_bodge_board.kicad_pcb

## KiCad design adsbee-0.0.1/adsbee-0.0.1/kicad/proto_amp_bodge_board/proto_amp_bodge_board.kicad_pcb (2025-06-24)

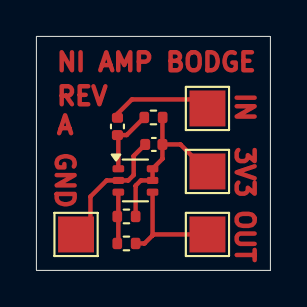
[picture p58: board proto_amp_bodge_board.kicad_pcb from above]

Board: 2 copper layers, 13.0 x 13.0 mm, 10 parts (0 on the bottom side), 6 nets.

Parts:
C1: 0.1uF; C_0402_1005Metric
C2: 22nF; C_0402_1005Metric
R1, R2: 10k; R_0402_1005Metric
R3: 100k; R_0402_1005Metric
TP1, TP2, TP3, TP4: TestPoint; TestPoint_Pad_2.0x2.0mm
U1: OPA358AIDCKR; SOT-363_SC-70-6

Connections:
+3V3: C1.1, R1.1, R2.1, TP3.1, U1.5 (ENABLE), U1.6 (V+)
GND: C1.2, TP4.1, U1.2 (V-)
unnamed: C2.1, TP2.1
unnamed: R3.2, TP1.1, U1.4
unnamed: C2.2, R1.2, U1.1 (+)
unnamed: R2.2, R3.1, U1.3 (-)
