MoseychukA/ASDB_INFO/adsbee-adsbee_1090-0.8.0-rc3/adsbee-adsbee_1090-0.8.0-rc3/kicad/saw_eval_board/saw_eval_board.kicad_pcb

## KiCad design adsbee-adsbee_1090-0.8.0-rc3/adsbee-adsbee_1090-0.8.0-rc3/kicad/saw_eval_board/saw_eval_board.kicad_pcb (2025-06-20)

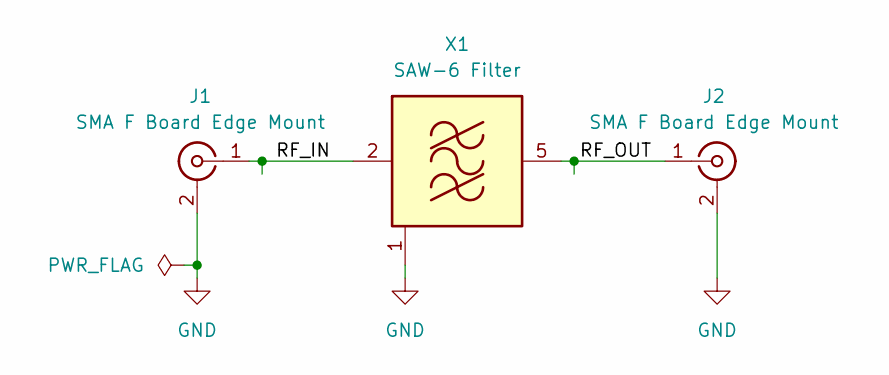
[picture p59: schematic saw_eval_board.kicad_sch]

Parts:
J1, J2: SMA F Board Edge Mount; SMA_Amphenol_132289_EdgeMount
X1: SAW-6 Filter; Filter_SAW-6_3.0x3.0mm

Connections:
/RF_IN: J1.1 (In), X1.2 (IN)
/RF_OUT: J2.1 (In), X1.5 (OUT)
GND: J1.2 (Ext), J2.2 (Ext), X1.1 (GND), X1.3 (GND), X1.4 (GND), X1.6 (GND)

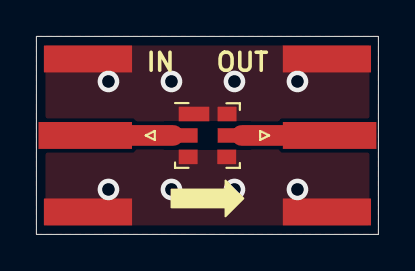
[picture p60: board saw_eval_board.kicad_pcb from above]

Board: 2 copper layers, 19.0 x 11.0 mm, 3 parts (0 on the bottom side), 3 nets.
