MoseychukA/ASDB_INFO/adsbee-adsbee_1090-0.8.0-rc3/adsbee-adsbee_1090-0.8.0-rc3/kicad/proto_tracking_comparator_board/proto_tracking_comparator_board.kicad_pcb

## KiCad design adsbee-adsbee_1090-0.8.0-rc3/adsbee-adsbee_1090-0.8.0-rc3/kicad/proto_tracking_comparator_board/proto_tracking_comparator_board.kicad_pcb (2025-06-20)

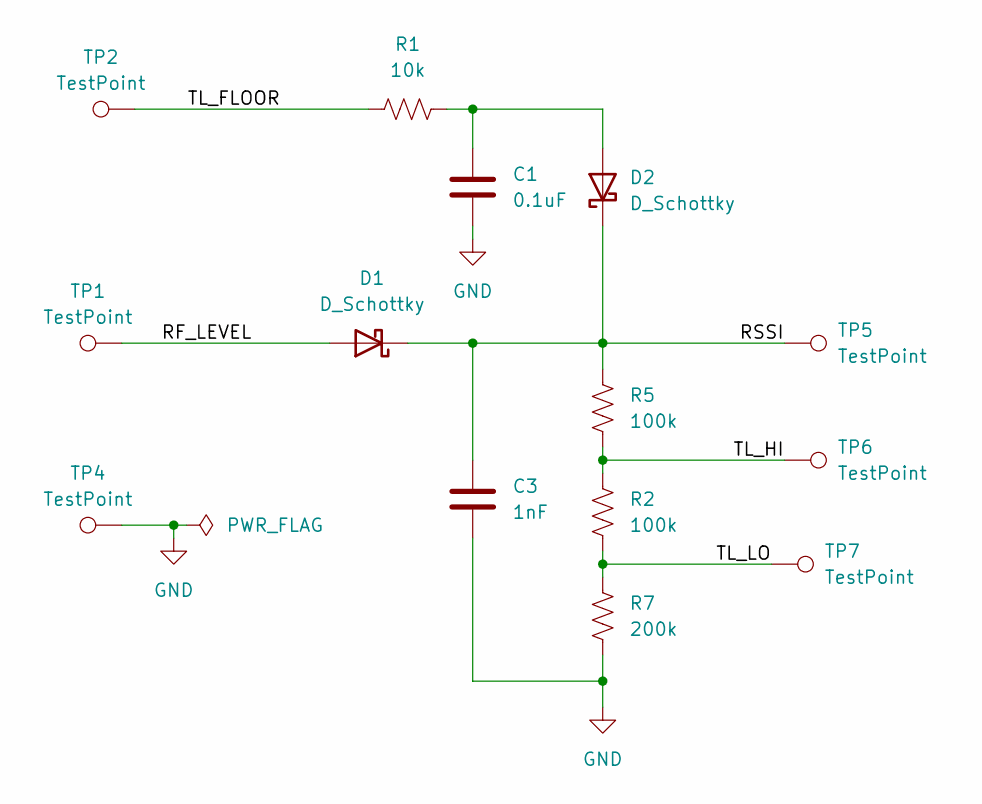
[picture p61: schematic proto_tracking_comparator_board.kicad_sch]

Parts:
C1: 0.1uF; C_0603_1608Metric
C3: 1nF; C_0603_1608Metric
D1, D2: D_Schottky; D_0402_1005Metric
R1: 10k; R_0603_1608Metric
R2, R5: 100k; R_0603_1608Metric
R7: 200k; R_0603_1608Metric
TP1, TP2, TP4, TP5, TP6, TP7: TestPoint; TestPoint_Pad_1.0x1.0mm

Connections:
/RF_LEVEL: D1.2 (A), TP1.1
/RSSI: C3.1, D1.1 (K), D2.1 (K), R5.2, TP5.1
/TL_FLOOR: R1.2, TP2.1
/TL_HI: R2.2, R5.1, TP6.1
/TL_LO: R2.1, R7.2, TP7.1
GND: C1.2, C3.2, R7.1, TP4.1
unnamed: C1.1, D2.2 (A), R1.1

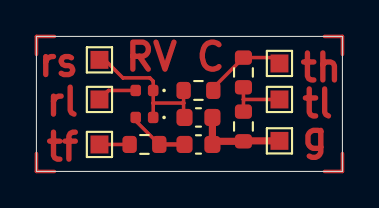
[picture p62: board proto_tracking_comparator_board.kicad_pcb from above]

Board: 2 copper layers, 17.0 x 7.5 mm, 14 parts (0 on the bottom side), 7 nets.
