MoseychukA/ASDB_INFO/adsbee-adsbee_1090-0.8.0-rc3/adsbee-adsbee_1090-0.8.0-rc3/kicad/proto_lna_board/proto_lna_board.kicad_pcb

## KiCad design adsbee-adsbee_1090-0.8.0-rc3/adsbee-adsbee_1090-0.8.0-rc3/kicad/proto_lna_board/proto_lna_board.kicad_pcb (2025-06-20)

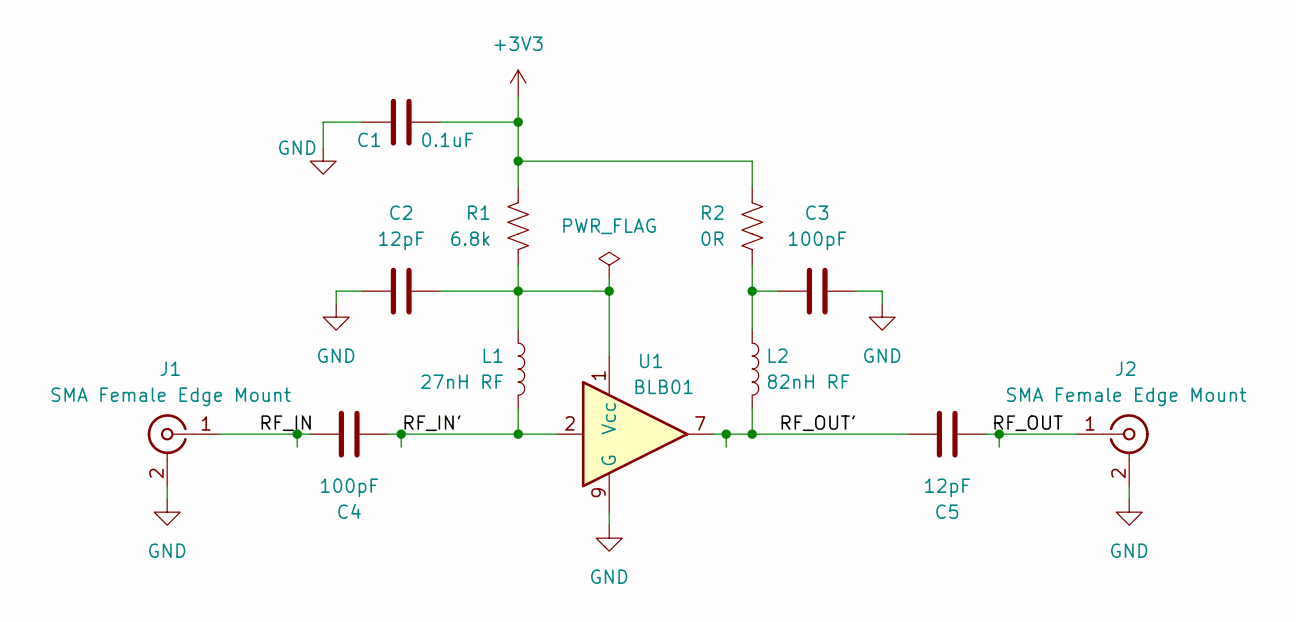
[picture p63: schematic proto_lna_board.kicad_sch]

Parts:
C1: 0.1uF; C_0402_1005Metric; MPN C60474
C2, C5: 12pF; C_0402_1005Metric; MPN C326662
C3, C4: 100pF; C_0402_1005Metric; MPN C106200
J1, J2: SMA Female Edge Mount; SMA_Amphenol_132289_EdgeMount
L1: 27nH RF; L_0402_1005Metric; MPN C408697
L2: 82nH RF; L_0402_1005Metric; MPN C54972
R1: 6.8k; R_0402_1005Metric; MPN C93940
R2: 0R; R_0402_1005Metric; MPN C60485
U1: BLB01; DFN-8-1EP_2x2mm_P0.5mm_EP0.9x1.5mm

Connections:
+3V3: C1.1, R1.1, R2.1
/RF_IN: C4.1, J1.1 (In)
/RF_IN': C4.2, L1.2, U1.2
/RF_OUT: C5.2, J2.1 (In)
/RF_OUT': C5.1, L2.2, U1.7
GND: C1.2, C2.1, C3.2, J1.2 (Ext), J2.2 (Ext), U1.9 (G)
unnamed: C3.1, L2.1, R2.2
unnamed: C2.2, L1.1, R1.2, U1.1 (Vcc)

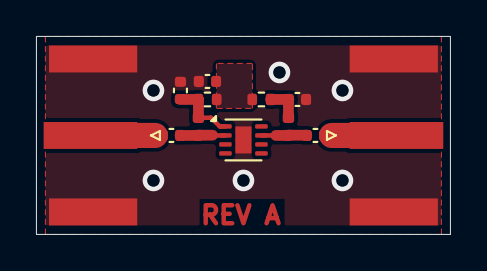
[picture p64: board proto_lna_board.kicad_pcb from above]

Board: 2 copper layers, 23.0 x 11.0 mm, 12 parts (0 on the bottom side), 8 nets.
