MoseychukA/ASDB_INFO/adsbee-adsbee_1090-0.8.0-rc3/adsbee-adsbee_1090-0.8.0-rc3/kicad/proto_data_slicer_board/proto_data_slicer_board.kicad_pcb

## KiCad design adsbee-adsbee_1090-0.8.0-rc3/adsbee-adsbee_1090-0.8.0-rc3/kicad/proto_data_slicer_board/proto_data_slicer_board.kicad_pcb (2025-06-20)

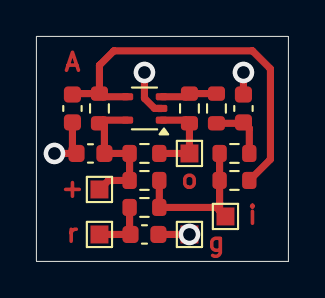
[picture p65: board proto_data_slicer_board.kicad_pcb from above]

Board: 2 copper layers, 14.0 x 12.5 mm, 18 parts (0 on the bottom side), 8 nets.

Parts:
C1: 100pF; C_0603_1608Metric
C2: 0.1uF; C_0603_1608Metric
C3: 3pF; C_0603_1608Metric
C4: 10nF; C_0603_1608Metric
R1, R3, R4: 10k; R_0603_1608Metric
R2, R5: 1M; R_0603_1608Metric
R6, R7, R8: 1k; R_0603_1608Metric
TP1, TP2, TP3, TP4, TP5: TestPoint; TestPoint_Pad_1.0x1.0mm
U1: MCP6566; SOT-353_SC-70-5

Connections:
+3V3: C2.1, R2.1, R7.1, R8.1, TP5.1, U1.5 (V+)
/IN: R1.1, R3.1, R6.1, R7.2, TP1.1
/LEVEL: C1.1, R1.2, R2.2, U1.4 (-)
/OUT: R5.2, R8.2, TP2.1, U1.1
/PULSE: C3.1, R3.2, R4.1
/PULSE': R4.2, R5.1, U1.3 (+)
/RSSI: C4.1, R6.2, TP3.1
GND: C1.2, C2.2, C3.2, C4.2, TP4.1, U1.2 (V-)
